irvintim/barn-blinds-controller/enclosure/rev3/check-report.txt

== 1. features
  Bottom valid=True solids=1  70.5 x 79.4 x 8.8 mm
  Lid    valid=True solids=1  70.5 x 79.4 x 16.8 mm
  markings whole and on flat faces: yes
  markings printable (strokes >= 0.6, gaps >= 0.5): yes
  inlays: brand 129 mm3 (26 pieces), labels 412 mm3 (55 pieces)
  vent slots open: 19 of 19
  side tag seated flush in its pocket: yes
  keyholes closed from inside: yes, head channel 1.80 mm tall
== 2. fit against the Rev 1.3 board
  29 of 109 parts can reach the case; testing those
  interference: none
  closest approach (mm):
      0.09  PCB                                      x[-32.5,32.5] y[-37.0,37.0] z[0.00,1.51]  <-- tight
      0.11  BarrelJack_Horizontal001                 x[21.9,36.1] y[-28.7,-19.4] z[-2.31,12.29]  <-- tight
      0.23  USB_Micro-B_XKB_U254-051T-4BH83-F1S      x[-33.0,-28.0] y[-28.7,-21.3] z[0.79,3.90]
      0.29  1786918                                  x[23.7,35.3] y[-11.2,24.6] z[-0.40,12.40]
      0.31  C_0805_2012Metric007                     x[0.4,2.4] y[32.3,33.6] z[-1.33,-0.08]
      0.32  C_0805_2012Metric015                     x[0.4,2.4] y[30.3,31.6] z[-1.33,-0.08]
      0.36  1790182                                  x[28.4,51.8] y[-11.1,24.7] z[0.36,13.65]
      0.41  C_0805_2012Metric005                     x[7.5,9.5] y[2.1,3.4] z[-1.33,-0.08]
      0.41  C_0805_2012Metric011                     x[7.5,9.5] y[23.3,24.6] z[-1.33,-0.08]
      0.65  B1205S-3WR2L-BodyPad001                  x[-12.3,7.4] y[-29.2,-22.2] z[-2.50,11.60]
      0.76  CP_Elec_10x10.5                          x[6.6,20.1] y[24.5,38.1] z[1.59,12.10]
      0.84  D_SMA003                                 x[28.9,31.6] y[15.2,20.2] z[-2.31,-0.08]
      0.84  D_SMA005                                 x[28.9,31.6] y[0.8,5.8] z[-2.31,-0.08]
      0.84  D_SMA007                                 x[28.9,31.6] y[22.3,27.3] z[-2.31,-0.08]
      0.84  D_SMA009                                 x[28.9,31.6] y[8.0,13.0] z[-2.31,-0.08]
      0.84  D_SMA011                                 x[-25.5,-20.5] y[-12.8,-10.1] z[-2.31,-0.08]
      0.84  D_SMA013                                 x[-25.5,-20.5] y[-17.4,-14.7] z[-2.31,-0.08]
      1.02  C_0805_2012Metric017                     x[-0.5,1.5] y[22.0,23.2] z[-1.33,-0.08]
      1.02  C_0805_2012Metric019                     x[-0.5,1.5] y[24.0,25.3] z[-1.33,-0.08]
      1.06  SOT-238                                  x[-22.8,-19.8] y[25.3,27.8] z[-1.28,-0.09]
      1.61  C_0805_2012Metric013                     x[-18.8,-16.8] y[28.1,29.4] z[-1.33,-0.08]
      1.81  C_0805_2012Metric009                     x[3.0,5.0] y[-22.0,-20.7] z[-1.33,-0.08]
      1.86  SOT-236                                  x[-26.3,-23.8] y[0.5,3.5] z[-1.28,-0.09]
      1.86  SOT-240                                  x[-26.2,-23.7] y[-4.5,-1.5] z[-1.28,-0.09]
      1.96  SOT-234                                  x[-28.0,-25.1] y[-26.2,-23.9] z[-1.19,-0.09]
      2.00  D_0805_2012Metric001                     x[-30.6,-29.4] y[26.4,28.4] z[1.59,2.40]
== 3. parameter robustness
  {'board_l': 80.0}                             ok
  {'wall': 3.0, 'edge_r': 1.5}                  ok
  {'kh_dx': 12.0, 'tv_n': 7, 'sv_n': 5}         ok
  {'headroom': 16.0, 'r_out': 4.0}              ok
  {'din_spacing': 36.0, 'side_cy': 3.0}         ok
== 4. exports
   exports/project-case-rev3-bottom.stl closed
   exports/project-case-rev3-lid.stl closed
   exports/project-case-rev3-lid-inlay-brand.stl closed
   exports/project-case-rev3-lid-inlay-labels.stl closed
   exports/project-case-rev3-side-tag.stl closed
   renders/assembled-plusX.png
   renders/assembled-minusX.png
   renders/tray-with-board.png
   renders/tray-inside.png
   renders/side-mount-minusX.png
   renders/tray-underside.png
   renders/lid-underside.png
   renders/lid-top-markings.png
   renders/tray-underside-markings.png
   renders/side-tag-plusX.png
== result: PASS
