irvintim/barn-blinds-controller/enclosure/rev3/renders/lid-underside.png

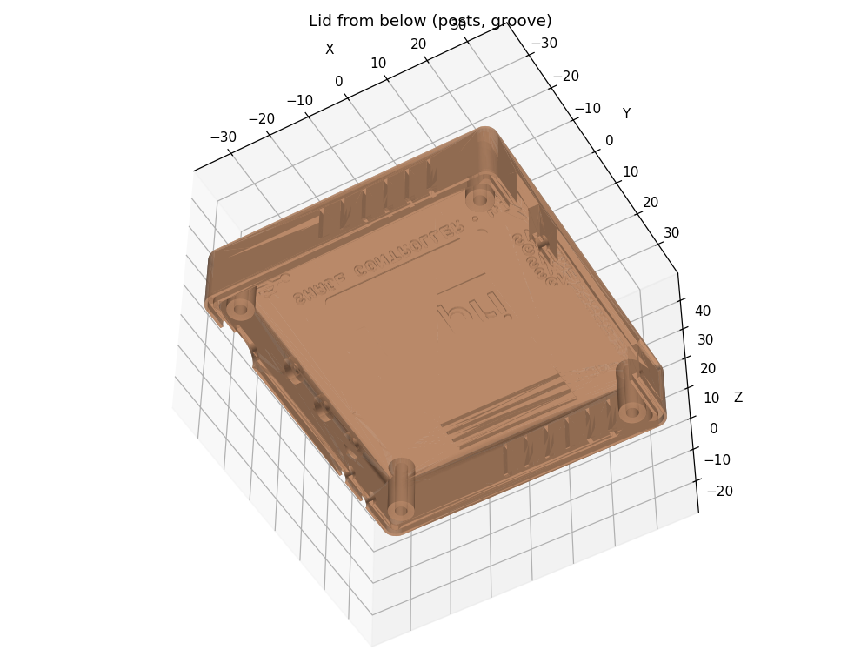
enclosure/rev3/renders/lid-underside.png
