irvintim/barn-blinds-controller/enclosure/rev3/renders/side-mount-minusX.png

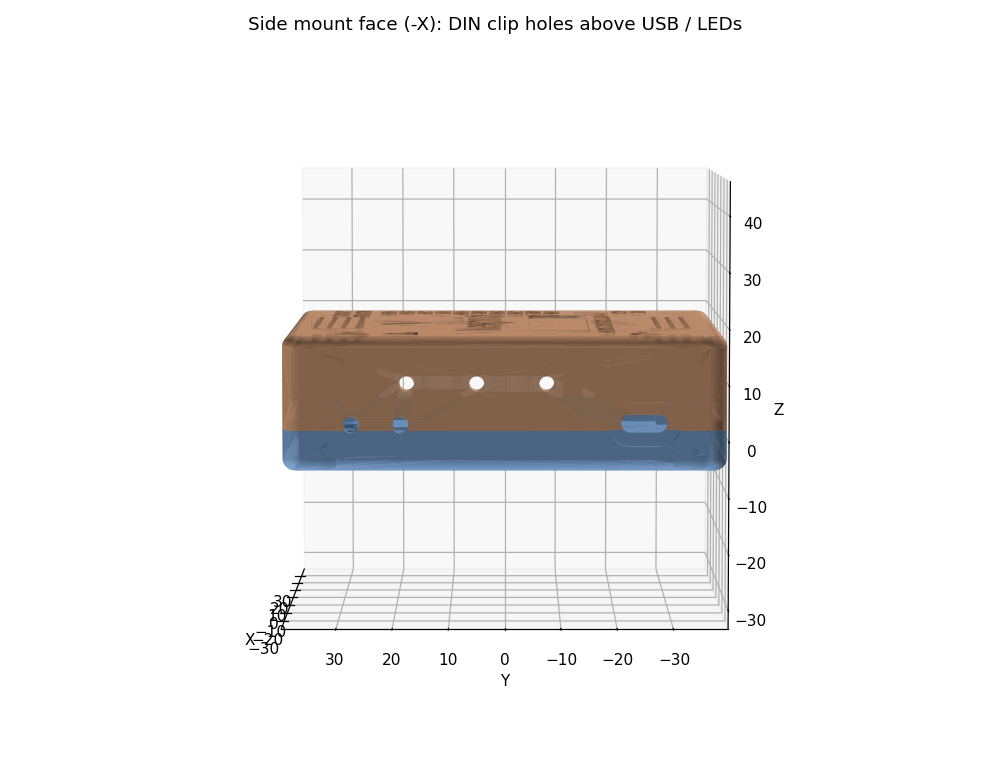
enclosure/rev3/renders/side-mount-minusX.png
