irvintim/barn-blinds-controller/enclosure/rev3/renders/tray-inside.png

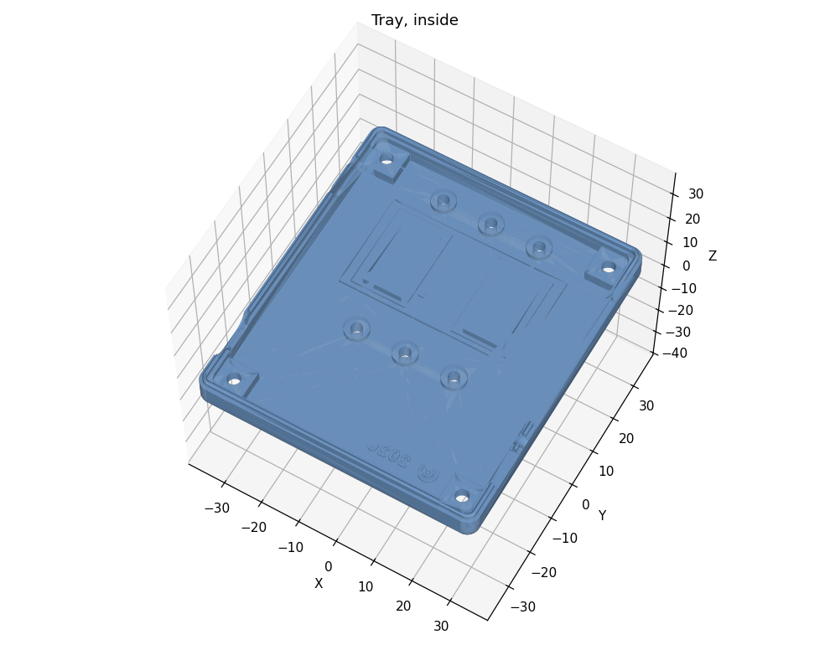
enclosure/rev3/renders/tray-inside.png
