irvintim/barn-blinds-controller/enclosure/rev3/renders/tray-underside-markings.png

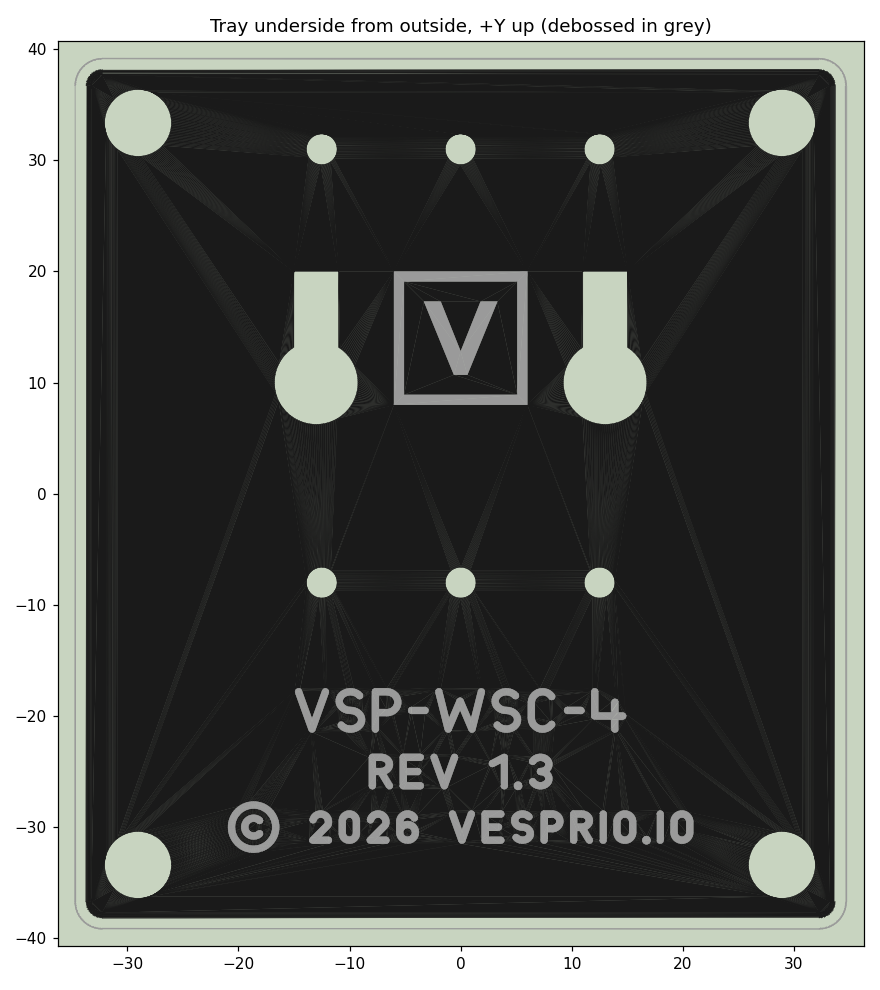
enclosure/rev3/renders/tray-underside-markings.png
