irvintim/barn-blinds-controller/enclosure/rev3/renders/tray-underside.png

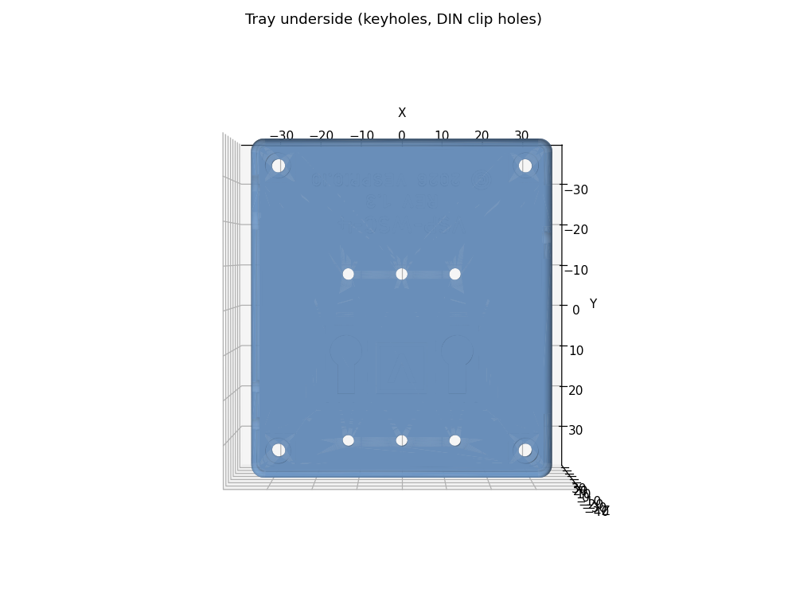
enclosure/rev3/renders/tray-underside.png
