irvintim/barn-blinds-controller/enclosure/rev3/renders/tray-with-board.png

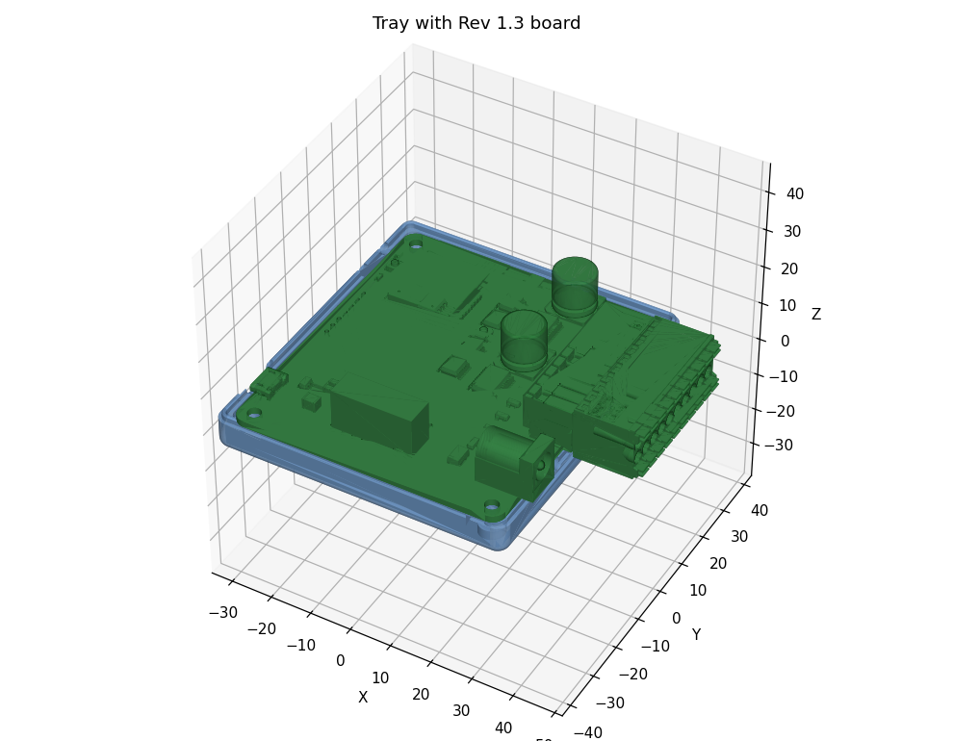
enclosure/rev3/renders/tray-with-board.png
