irvintim/barn-blinds-controller/LIB_SLC03A-05/SLC03A-05/3D/Pasted image.png

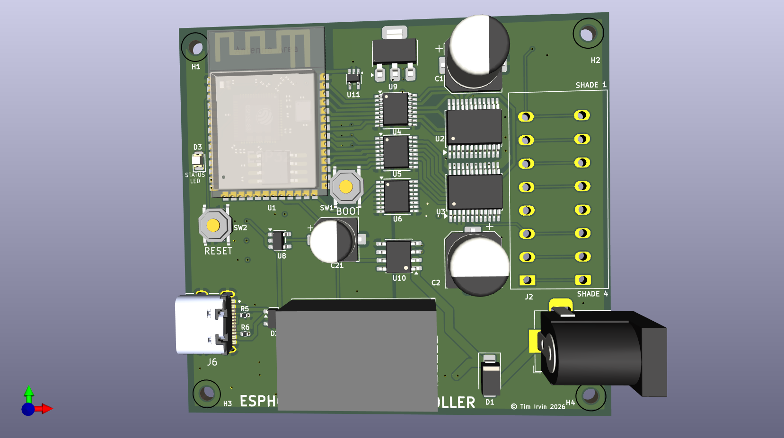
LIB_SLC03A-05/SLC03A-05/3D/Pasted image.png
