irvintim/barn-blinds-controller/pcb/main-board/fab/vsp-wsc4-rev1.3/cdadb2f582784c6c8320a630f22a9e84_T.png

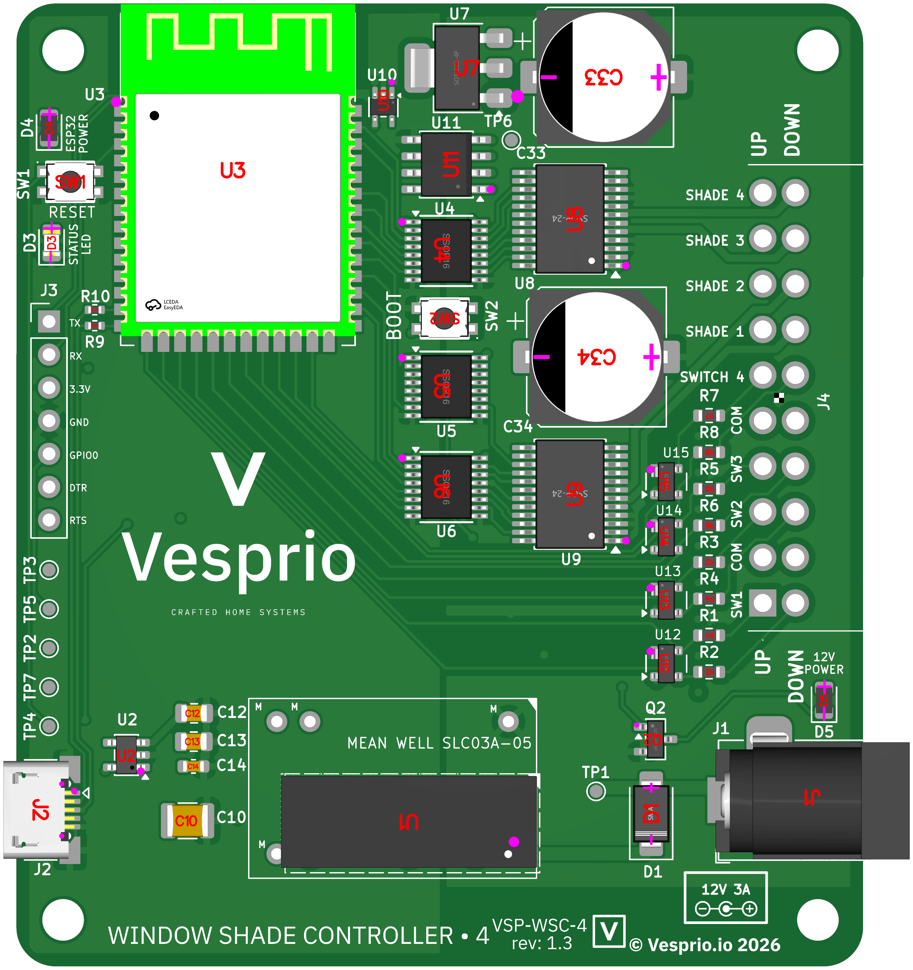
pcb/main-board/fab/vsp-wsc4-rev1.3/cdadb2f582784c6c8320a630f22a9e84_T.png
