irvintim/barn-blinds-controller/production/537245f37e364ca3bb9c5b8609c065dc_B.png

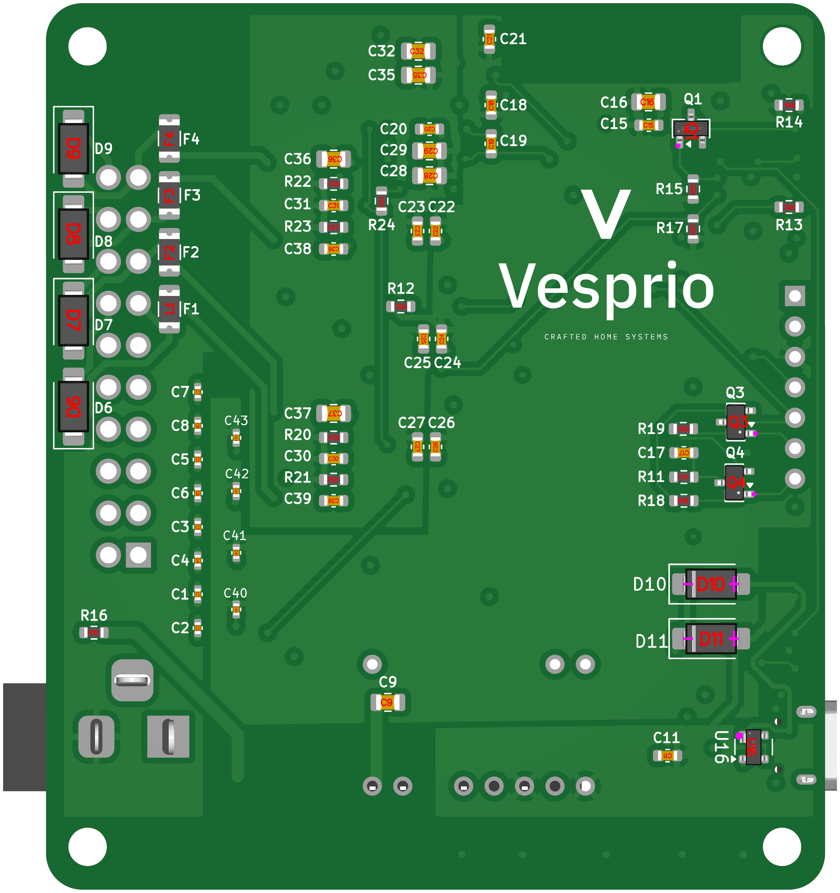
production/537245f37e364ca3bb9c5b8609c065dc_B.png
