irvintim/barn-blinds-controller/barn-blinds-controller-JLCPCB-BOM-v1.1.xlsx

Comment | Designator | Footprint | JLCPCB Part#(optional)
22uF 25V | C1 | 0805 | C45783
100uF | C2 | CP_Elec_6.3x5.4 | C7469977
0.1uF 25V | C3,C6,C7,C_ACS1,C_ISO_A1,C_ISO_B1,C_ISO_C1,C_ISO_D1,C_ISO_E1,C_ISO_F1,C_TMP1 | 0603 | C1590
10uF 10V | C4,C8,C_VCC_A1,C_VCC_A2 | 0805 | C17024
22uF 10V | C5,C10 | 0805 | C29277
10uF 25V | C9,C_VM_A1,C_VM_A2 | 0805 | C15850
1000uF 25V | C11,C12 | CP_Elec_10x10.5 | C7471896
10nF 10V | C_ACS2 | 0603 | C519405
1nF 10V | C_FILT1 | 0603 | C519402
0.1uF 25V | C_VCC_B1,C_VCC_B2,C_VM_B1,C_VM_B2 | 0603 | C1590
SS34 | D1 | SMA | C8678
BAT54S | D2 | SOT-23 | C8592
SMBJ15CA | D4,D5,D6,D7 | SMB | C19077570
Polyfuse mSMD110 | F1,F2,F3,F4 | 1812 | C69691
DC005-T25 | J1 | BarrelJack_Horizontal | C111573
KH-TYPE-C-16P | J2 | KH-TYPE-C-16P | C709357
Conn_01x08 3.5mm | J3 | TerminalBlock_JL271R_1x08_P3.50mm | C5137858
5.1K | R1,R4 | 0402 | C25905
22R | R2,R3 | 0402 | C25092
10K | R5,R6,R7,R8,R9,R10,R_BOOT1 | 0603 | C25804
330R | R_LED1 | 0603 | C23138
BOOT | SW1 | SW-SMD_4P | C51927445
BOOT | SW2 | SW-SMD_4P | C51927445
AP2112K-3.3 | U2 | SOT-23-5 | C23380830
ESP32-S3-WROOM-1 | U3 | ESP32-S3-WROOM-1 | C2913197
ISO7760DBQ | U4,U5,U6 | SSOP-16 | C2868628
AMS1117-3.3 | U7 | SOT-223 | C6186
TB6612FNG | U8,U9 | SSOP-24 | C88224
TMP235 | U10 | SC-70-5 | C2861437
ACS723xLCTR-05AB | U11 | SOIC-8 | C2655492
Red LED | D3 | 0805 | C84256
