irvintim/barn-blinds-controller/JLCPCB_BOM_Template.xls

Comment | Designator | Footprint | JLCPCB Part#(optional)
100uF | C1 | CASE-B_3528 | C16133
100nF | C2, C9, C10 | 0603 | C14663
300KΩ | R4, R7 | 0603 | C23024
15KΩ | R5, R6 | 0603_R | C22809
100KΩ | R1, R3 | 0603_R | C25803
10uF | C3-5 | 1206_C | C13585
100Ω | R2 | 0603_R | C22775
1N4148WS | D1 | SOD-323 | C2128
LM358DR2G | U1 | SOIC-8_150mil | C7950
HT7550-1 | VR1 | SOT-89(SOT-89-3) | C16106
