irvintim/barn-blinds-controller/enclosure/reference/barn-blinds-controller.FCStd

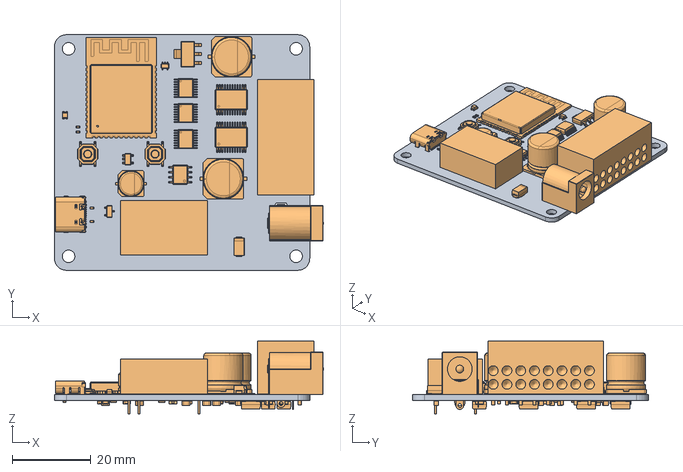
[picture p12: CAD file, 2026-07-08]
enclosure/reference/barn-blinds-controller.FCStd
68.5 x 60.0 x 18.5 mm
PCB_Compound
Component_Compound
