irvintim/barn-blinds-controller/enclosure/rev3/exports/project-case-rev3-lid.stl

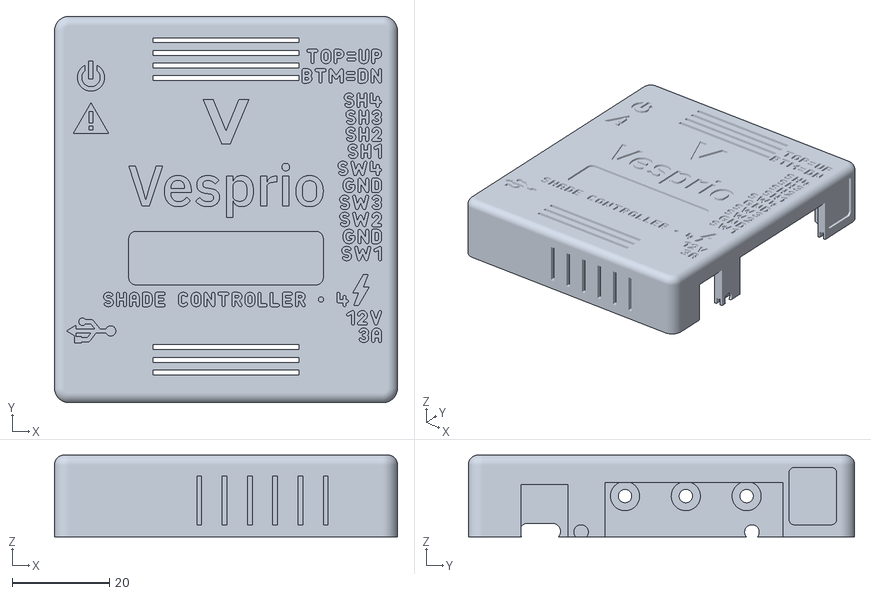
[picture p13: CAD file, 2026-10-15]
enclosure/rev3/exports/project-case-rev3-lid.stl
70.5 x 79.4 x 16.8
