irvintim/barn-blinds-controller/enclosure/rev3/project-case-rev3.FCStd

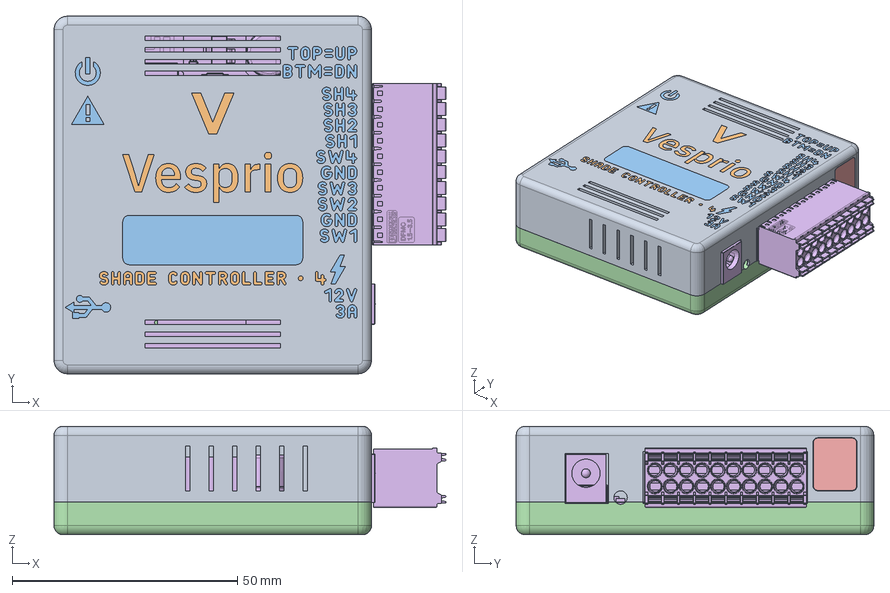
[picture p14: CAD file, 2026-10-15]
enclosure/rev3/project-case-rev3.FCStd
87.0 x 79.4 x 24.1 mm
LidPrint
InlayBrand
InlayLabels
TrayPrint
SideTag (print flat, white; glue into the +X wall pocket)
Board Rev 1.3 (reference, not printed)
