irvintim/barn-blinds-controller/KH-TYPE-C-16P/KH-TYPE-C-16P.step

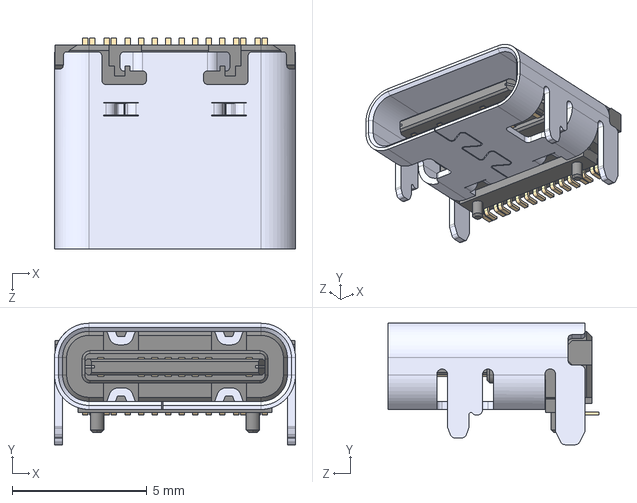
[picture p15: CAD file, 2026-04-21]
KH-TYPE-C-16P/KH-TYPE-C-16P.step
8.94 x 4.51 x 7.81 mm
