irvintim/barn-blinds-controller/LIB_SLC03A-05/SLC03A-05/3D/SLC03A-05.stp

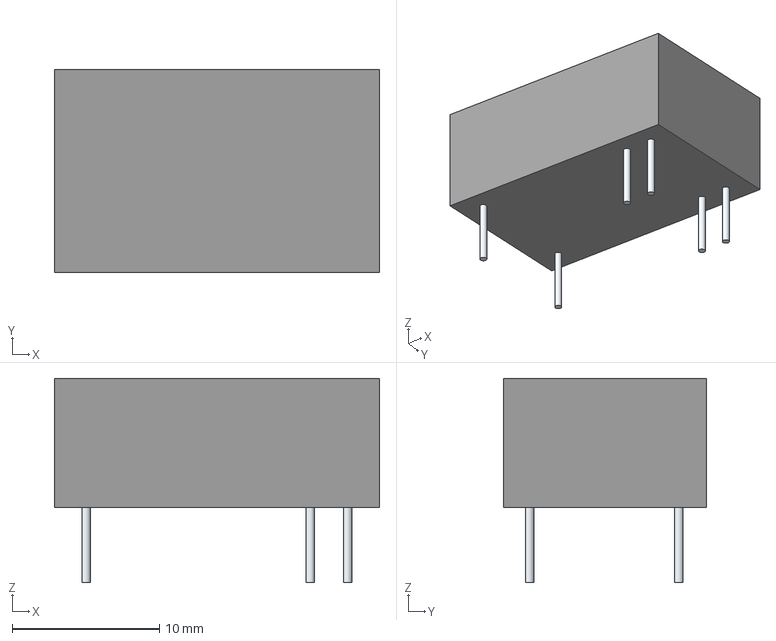
[picture p16: CAD file, 2026-04-21]
LIB_SLC03A-05/SLC03A-05/3D/SLC03A-05.stp
22.1 x 13.8 x 13.9 mm
Leads x 6
