irvintim/barn-blinds-controller/project-case-BodyPocket004.stl

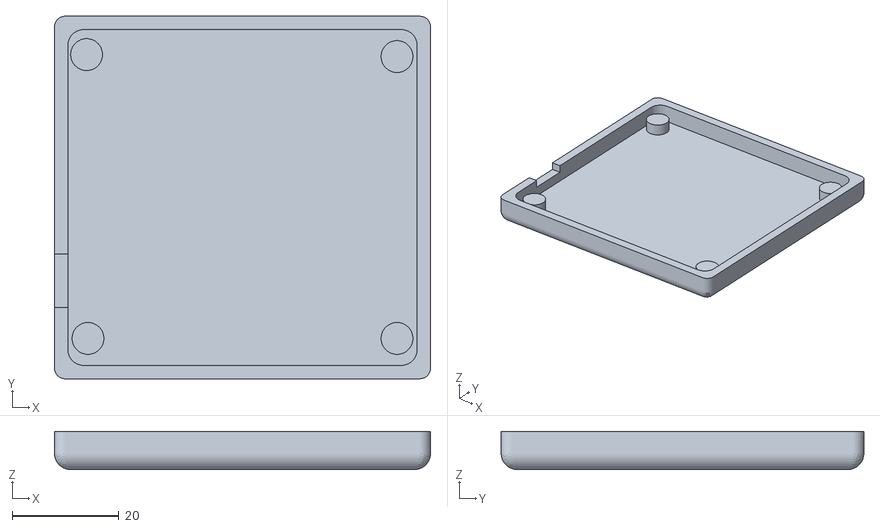
[picture p17: CAD file, 2026-07-08]
project-case-BodyPocket004.stl
70.5 x 68.0 x 7.16
