irvintim/barn-blinds-controller/enclosure/reference/1597DIN2GY.stp

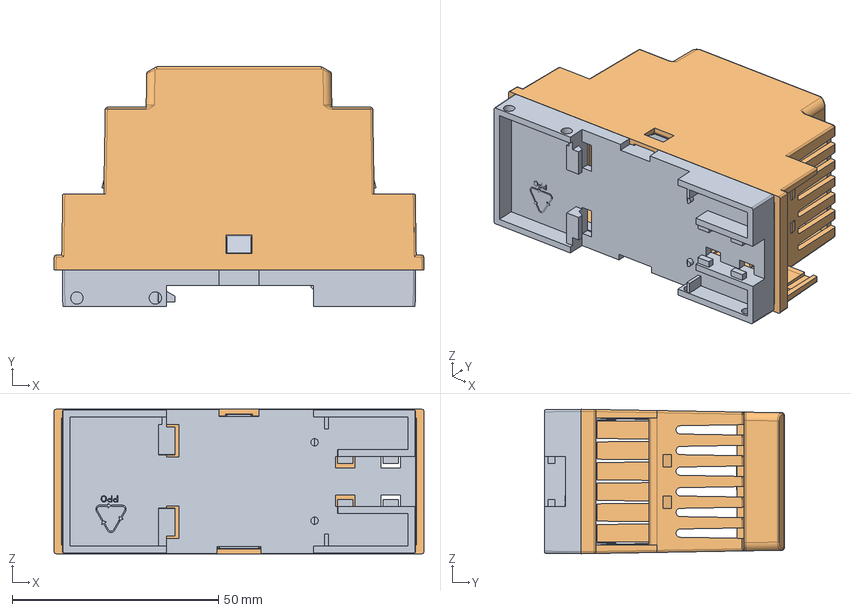
[picture p18: CAD file, 2026-06-30]
enclosure/reference/1597DIN2GY.stp
89.6 x 58.0 x 35.0 mm
350_base_121113
top_stbx_35mm_rev-a
