irvintim/barn-blinds-controller/enclosure/rev3/exports/project-case-rev3-bottom.stl

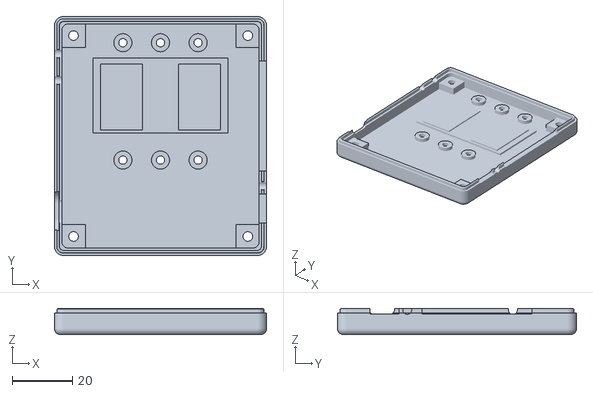
[picture p19: CAD file, 2026-10-15]
enclosure/rev3/exports/project-case-rev3-bottom.stl
70.5 x 79.4 x 8.75
