irvintim/barn-blinds-controller/enclosure/rev3/exports/project-case-rev3-lid-inlay-labels.stl

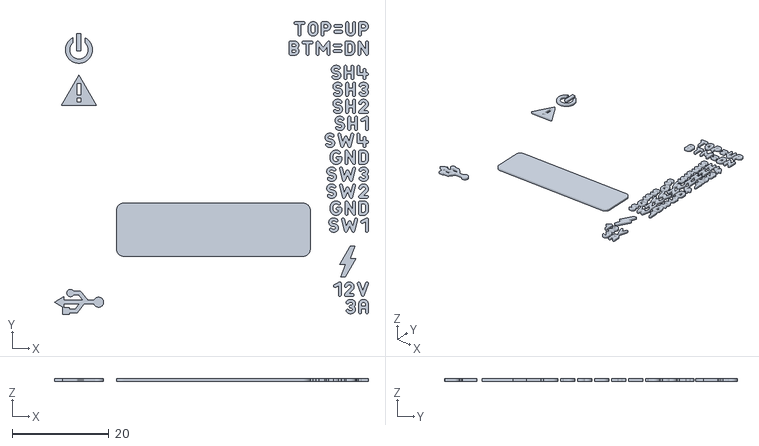
[picture p20: CAD file, 2026-10-15]
enclosure/rev3/exports/project-case-rev3-lid-inlay-labels.stl
64.8 x 60.4 x 0.6
