irvintim/barn-blinds-controller/project-case-Cut001.stl

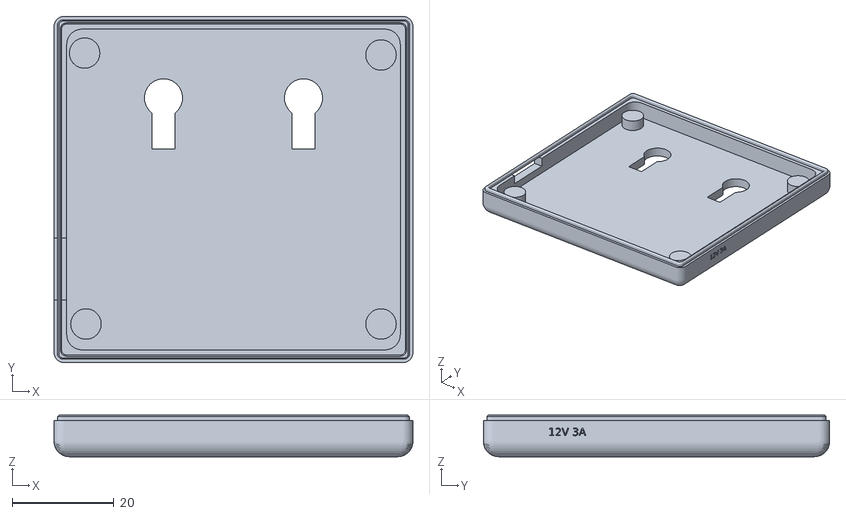
[picture p21: CAD file, 2026-07-08]
project-case-Cut001.stl
70.5 x 68.0 x 8.16
