irvintim/barn-blinds-controller/project-case-TopPocket011.stl

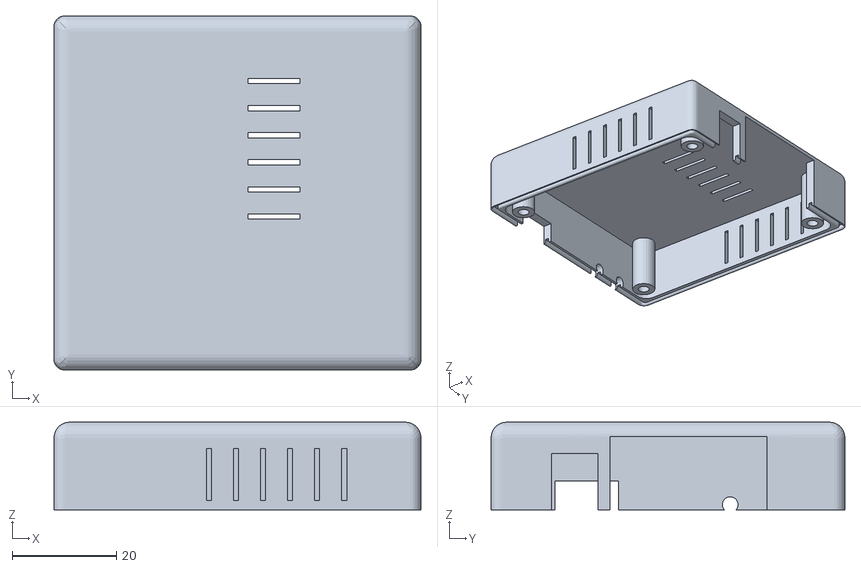
[picture p22: CAD file, 2026-07-08]
project-case-TopPocket011.stl
70.5 x 68.0 x 16.8
