irvintim/barn-blinds-controller/enclosure/rev3/exports/project-case-rev3-lid-inlay-brand.stl

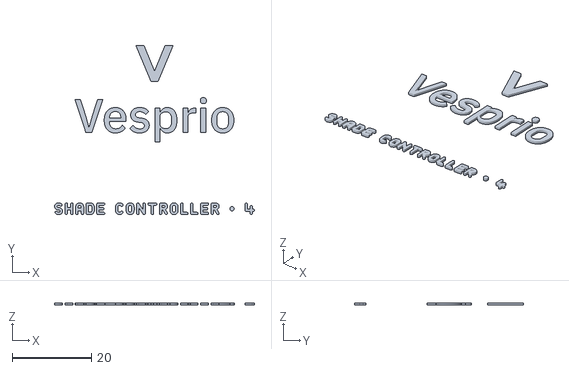
[picture p23: CAD file, 2026-10-15]
enclosure/rev3/exports/project-case-rev3-lid-inlay-brand.stl
50.4 x 42.7 x 0.6
