irvintim/barn-blinds-controller/project-case.FCStd

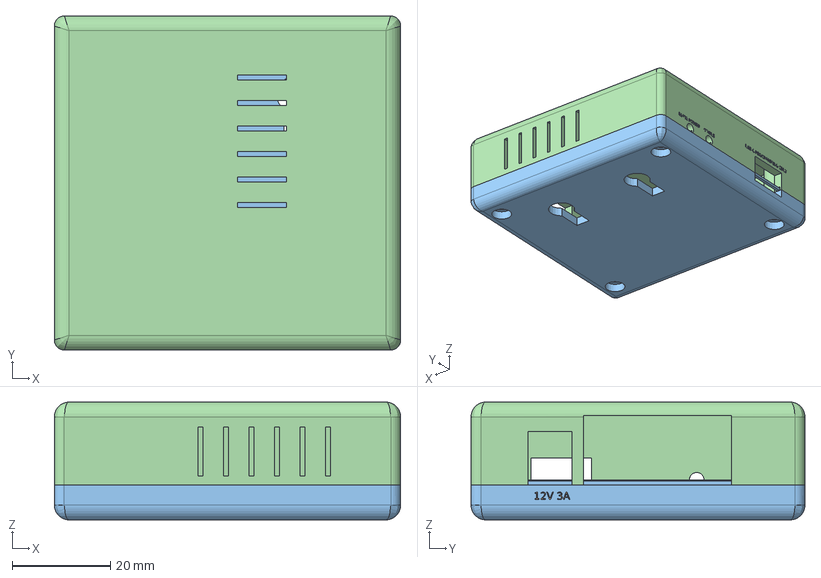
[picture p24: CAD file, 2026-07-08]
project-case.FCStd
70.5 x 68.0 x 24.0 mm
ShapeString006
