irvintim/barn-blinds-controller/enclosure/rev3/exports/lid-proof-base.stl

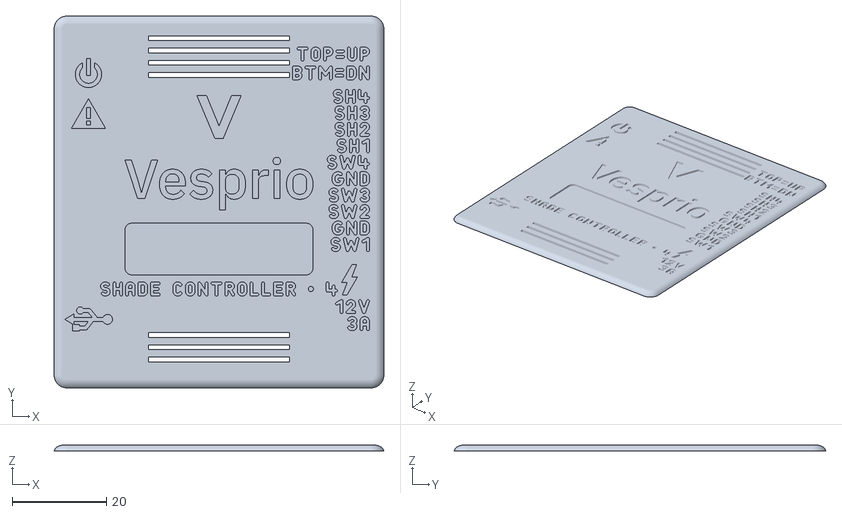
[picture p25: CAD file, 2026-10-15]
enclosure/rev3/exports/lid-proof-base.stl
70.2 x 79.1 x 1.20
