irvintim/barn-blinds-controller/R15P23.3S_X2_P_R6.4--3DModel-STEP-510211.STEP

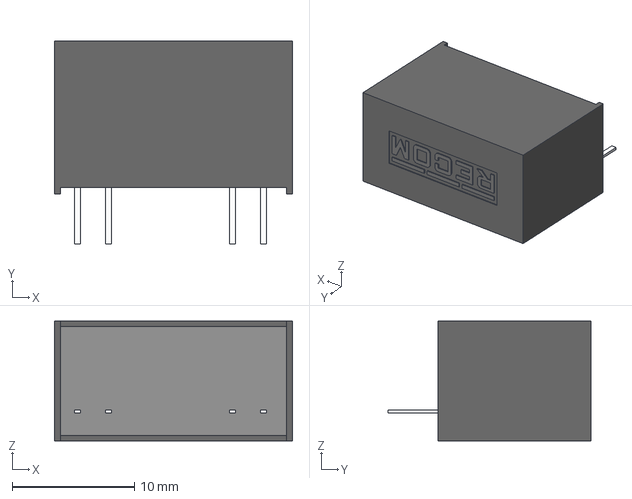
[picture p26: CAD file, 2026-07-08]
R15P23.3S_X2_P_R6.4--3DModel-STEP-510211.STEP
19.5 x 16.6 x 9.80 mm
