irvintim/barn-blinds-controller/enclosure/rev3/exports/project-case-rev3-side-tag.stl

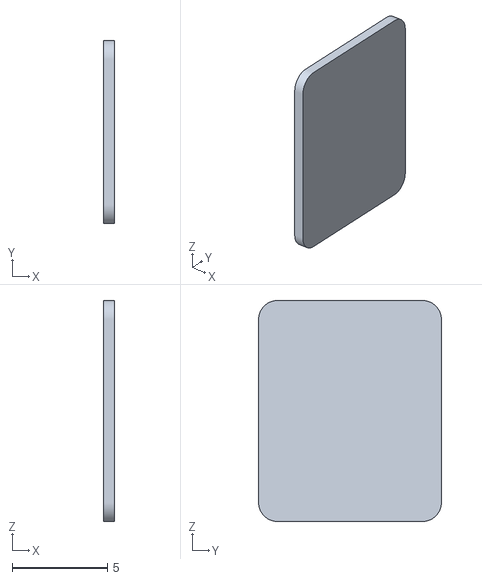
[picture p27: CAD file, 2026-10-15]
enclosure/rev3/exports/project-case-rev3-side-tag.stl
0.6 x 9.60 x 11.6
