irvintim/barn-blinds-controller/project-case-repaired.FCStd

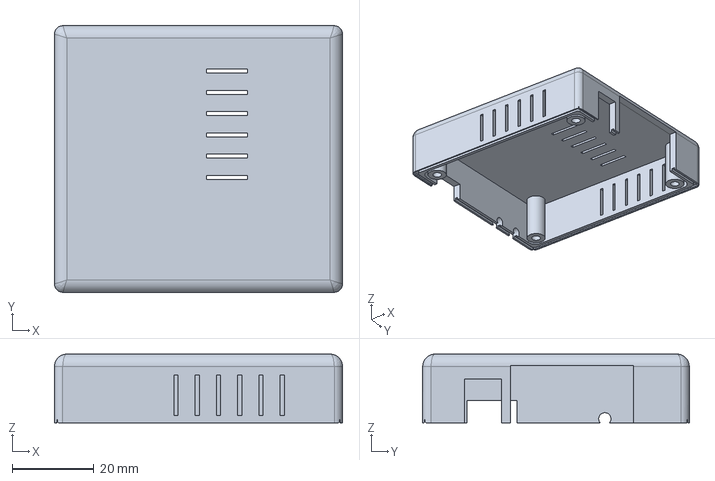
[picture p28: CAD file, 2026-07-08]
project-case-repaired.FCStd
70.5 x 65.2 x 16.8 mm
