irvintim/barn-blinds-controller/enclosure/rev3/exports/inlay-test-tile-base.stl

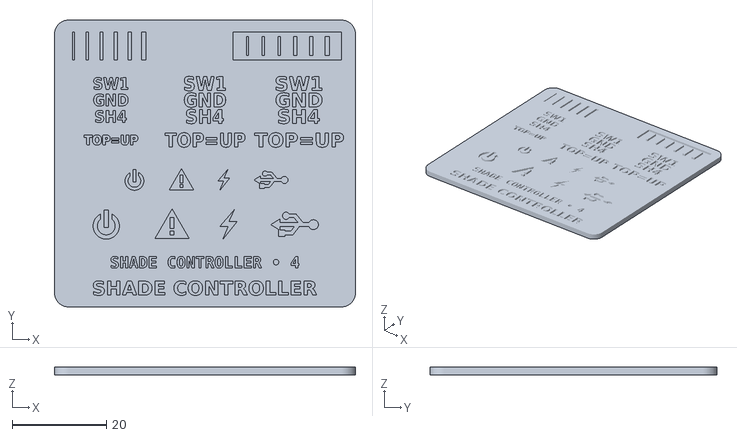
[picture p29: CAD file, 2026-10-15]
enclosure/rev3/exports/inlay-test-tile-base.stl
64.0 x 61.0 x 1.60
