irvintim/barn-blinds-controller/project-case-Body001LinearPattern.step

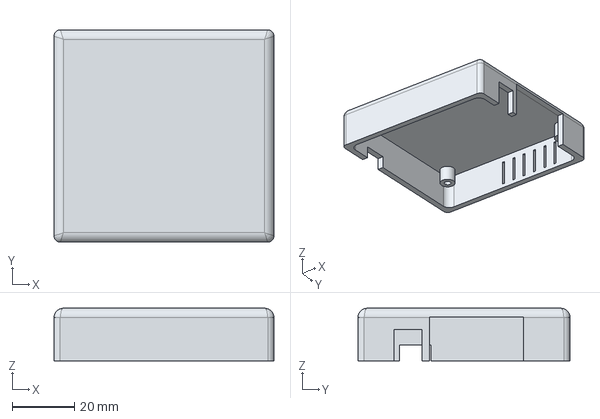
[picture p30: CAD file, 2026-07-08]
project-case-Body001LinearPattern.step
70.5 x 68.0 x 16.8 mm
