irvintim/barn-blinds-controller/enclosure/rev3/exports/inlay-test-tile-white.stl

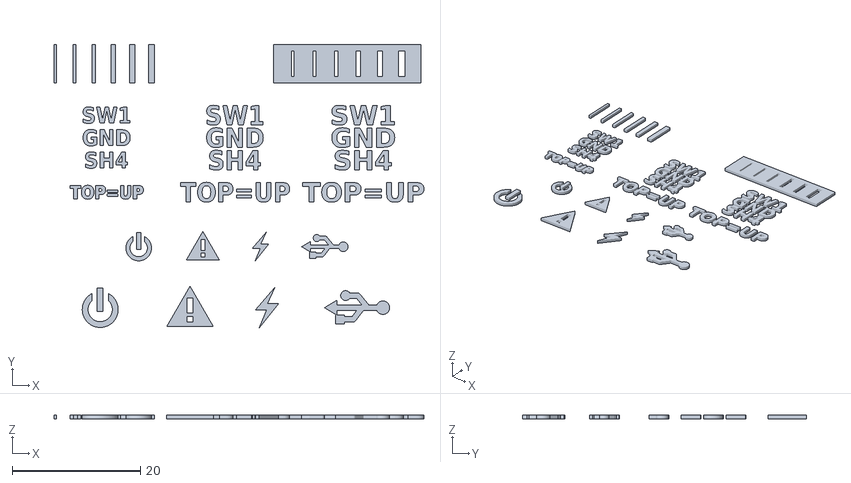
[picture p31: CAD file, 2026-10-15]
enclosure/rev3/exports/inlay-test-tile-white.stl
57.7 x 44.2 x 0.6
