irvintim/barn-blinds-controller/enclosure/rev3/exports/inlay-test-tile-blue.stl

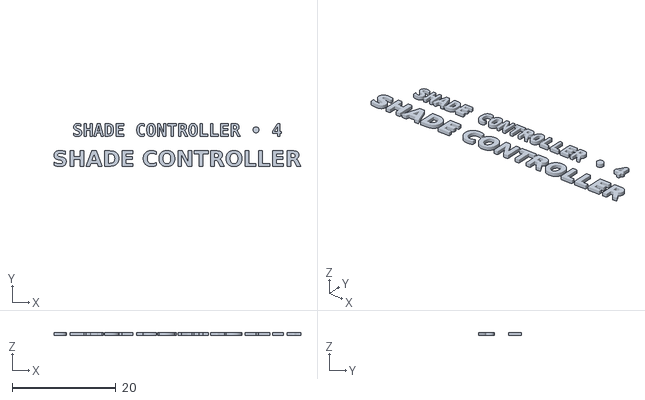
[picture p32: CAD file, 2026-10-15]
enclosure/rev3/exports/inlay-test-tile-blue.stl
47.5 x 8.32 x 0.6
