irvintim/barn-blinds-controller/JL271R-35008G01.FCStd

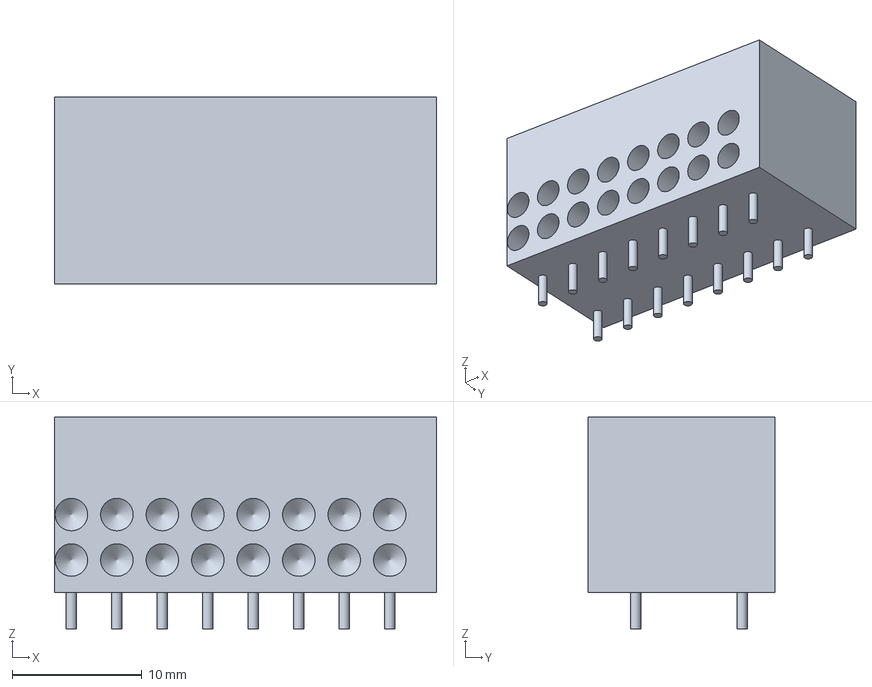
[picture p33: CAD file, 2026-04-24]
JL271R-35008G01.FCStd
29.4 x 14.4 x 16.3 mm
