irvintim/barn-blinds-controller/EEVTG2A221M.STEP

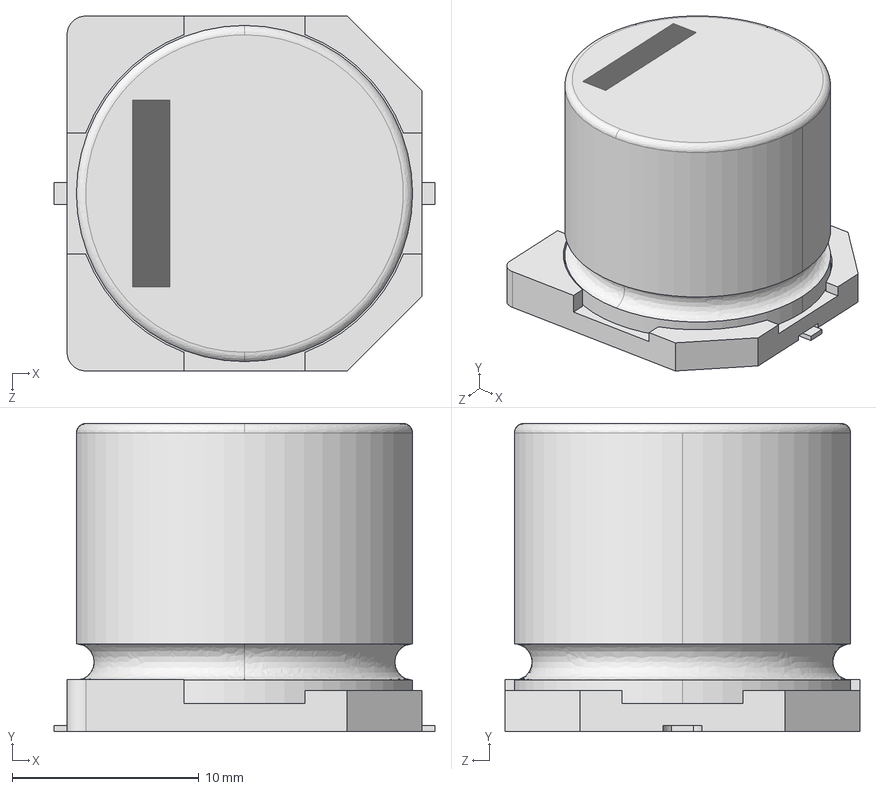
[picture p34: CAD file, 2026-04-23]
EEVTG2A221M.STEP
20.4 x 16.5 x 19.0 mm
