irvintim/barn-blinds-controller/(list of files, cad)

Other CAD files:
project-case-rev2-TopSketch020.stl
enclosure/rev3/exports/lid-proof-white.stl
enclosure/rev3/exports/lid-proof-blue.stl
project-case-BottomChamfer.stl
B1205S-3WR2L-BodySketch001.step
barn-blinds-controller.step
JL271R-35008G01-BodyPad001.stl
JL217R-35008G01-BodyPad001.step
1054070/3D/1054070.stp
1054070/Allegro/1054070.psm
1054070/DEHDL/1054070/chips/chips.prt
1786918/Allegro/1786918.psm
1786918/DEHDL/1786918/chips/chips.prt
1787470/3D/1787470.stp
1787470/Allegro/1787470.psm
1787470/DEHDL/1787470/chips/chips.prt
1790373/1790373.stp
JL217R-35008G01-BodyPad001.stl
LIB_SLC03A-05/SLC03A-05/Allegro/slc03a05.psm
LIB_SLC03A-05/SLC03A-05/DEHDL/slc03a_05/chips/chips.prt
enclosure/archive/rev1/exports/project-case-Body001LinearPattern.stl
enclosure/archive/rev1/exports/project-case-BottomChamfer.stl
enclosure/archive/rev1/exports/project-case.amf
enclosure/rev2/exports/Assembly.3mf
enclosure/rev2/exports/project-case-rev2-BottomPocket013.stl
enclosure/rev2/exports/project-case-rev2-BottomPocket018.stl
enclosure/rev2/exports/project-case-rev2-TopPocket015.stl
enclosure/rev2/project-case-rev2.FCStd
project-case-Body001LinearPattern.stl
project-case-Cut001.amf
project-case.3mf
project-case.amf
