irvintim/barn-blinds-controller/enclosure/rev3/renders/assembled-minusX.png

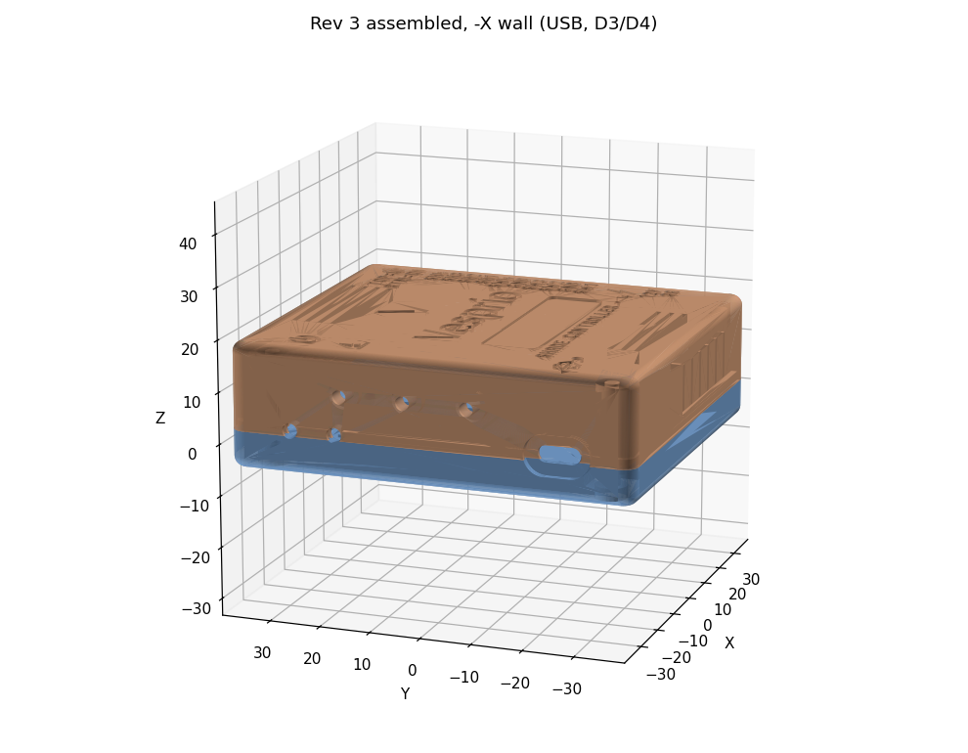
enclosure/rev3/renders/assembled-minusX.png
