irvintim/barn-blinds-controller/docs/project-context/vsp-wsc4-rev13-bringup-status.md

# VSP-WSC-4 Rev 1.3 — Bring-up STATUS LOG

**Live status of the physical Rev 1.3 boards.** Updated 2026-10-11.

This is the "where did I leave off" file. The step-by-step test plan is
`vsp-wsc4-rev13-bringup-procedure.md`; the config is
`vsp-wsc4-rev13-bringup.yaml`. Everything needed is git-tracked — nothing
important lives only on one machine.

---

## THE NEXT THING TO DO

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

What is left needs the **real shade motors** (they are on the job site):
1. Measure each shade motor's **inrush and stall current** — with a clamp meter
   or a bench supply, NOT through a board first. This sets the stall threshold
   and confirms the motors are inside the TB6612FNG's 1.2 A / 3.2 A rating.
2. Then run one real shade motor on board 2 under control, watching Reset Reason
   for brownout (Rev 1.4 item 4: the ESP32 drops out below ~8.5 V on `+12V_RAW`).
3. Confirm which physical direction "OPEN" drives.

**Still the rule: no motor on any board until step 1 is done.** A non-shade
motor destroyed board 1's U8. Resistive load for anything else: **20-33 ohm,
10 W cement** (never below 20 ohm on an output).

Firmware items found today (not board items): switch debounce in all configs,
soft-start, Tasmota switch inputs + stall detection. See the Product Track list
in `vsp-wsc4-todo.md`.

---

## Board inventory

| Board | State | Notes |
|---|---|---|
| **1** | **FAULTY — U8 destroyed** | VM and 3 of 4 output legs shorted to PGND. Repairable: replace U8 (SSOP-24), confirm VM->PGND open before applying 12 V. Nothing else on it is damaged. |
| **2** | Healthy — **now running Tasmota 15.6.0.3** | Full resistance baseline taken 2026-09-03 — every reading open. **Use board 2 as the reference when a board is suspect.** Reflashed from ESPHome to Tasmota 2026-10-11 (serial, via J3); to go back to the bring-up config it needs a serial/USB flash again. |
| 3-5 | Unopened | |

---

## Status at a glance

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

---

## Findings this session (all fixed in the repo, all worth remembering)

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

```
GPIO42 -> U3.35 -> ISO_SH3_OPEN -> U4.4 (INC) -> U4.13 (OUTC)
       -> SH3_IN1 -> U8.17 (BIN1) -> ch B -> BO1/BO2 -> SHADE4 -> J4.10/20
```

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

---

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

Note TP1 is `Net-(D1-A)` (the raw input, *before* D1), not `+12V`.

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

### 14. Tasmota on Rev 1.3 — all four shutters work, and why Rev 1.2's didn't (2026-10-11)
**Passed:** Shade 1 ±11.31 V, 2 ±11.47 V, 3 ±11.10 V, 4 ±11.36 V, each driving
only its own J4 pair, opposite polarity open/close, `ShutterStop` works, no
restarts. Tasmota 15.6.0.3. Full procedure and template:
`tasmota-setup-commands.txt`. Things that cost time, in order:

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

---

## Working on a different machine

**Normal path (what is actually used):** `git pull`, open
`vsp-wsc4-rev13-bringup.yaml` in the IDE, copy the whole file, paste it into the
ESPHome Docker dashboard's web editor, Save + Install. See Finding 9 for the
traps that come with this.

**CLI path**, if ever needed:

```bash
git pull
python3 -m venv ~/.venvs/esphome && ~/.venvs/esphome/bin/pip install esphome
cp docs/project-context/secrets.yaml.example docs/project-context/secrets.yaml  # then edit
~/.venvs/esphome/bin/esphome run docs/project-context/vsp-wsc4-rev13-bringup.yaml
```

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

---

## Deferred by decision

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

## For Rev 1.4

**The canonical Rev 1.4 list lives in `vsp-wsc4-todo.md` under
"Rev 1.4 PCB Changes".** Add new items there, not here, so the two do not
drift. As of 2026-10-11 none of them is required for the shade-controller use
case — see "THE NEXT THING TO DO" above.
