irvintim/barn-blinds-controller/enclosure/rev3/renders/inlay-test-tile.png

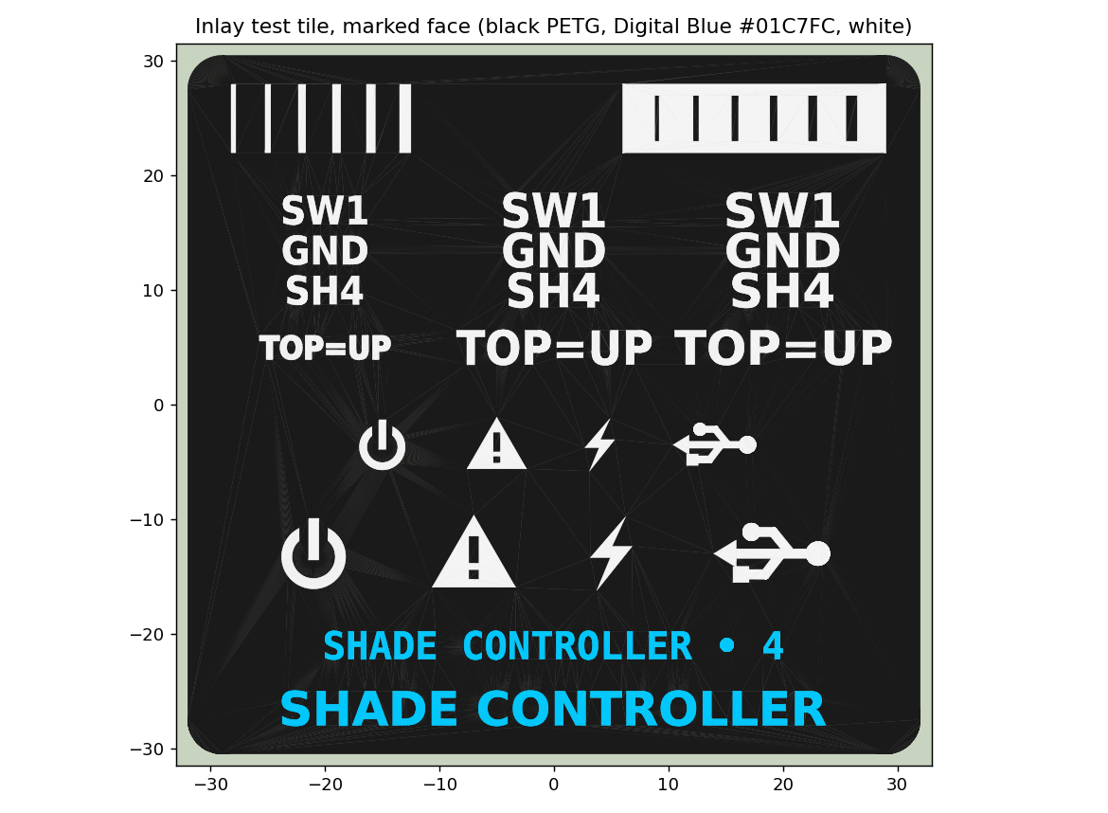
enclosure/rev3/renders/inlay-test-tile.png
