irvintim/barn-blinds-controller/(list of files, drawings)

Other design files:
1786918/Altium/1786918.PcbLib
1786918/Altium/1786918.SchLib
