irvintim/barn-blinds-controller/pcb/main-board/barn-blinds-controller.kicad_pcb

## KiCad design pcb/main-board/barn-blinds-controller.kicad_pcb (2026-10-12)

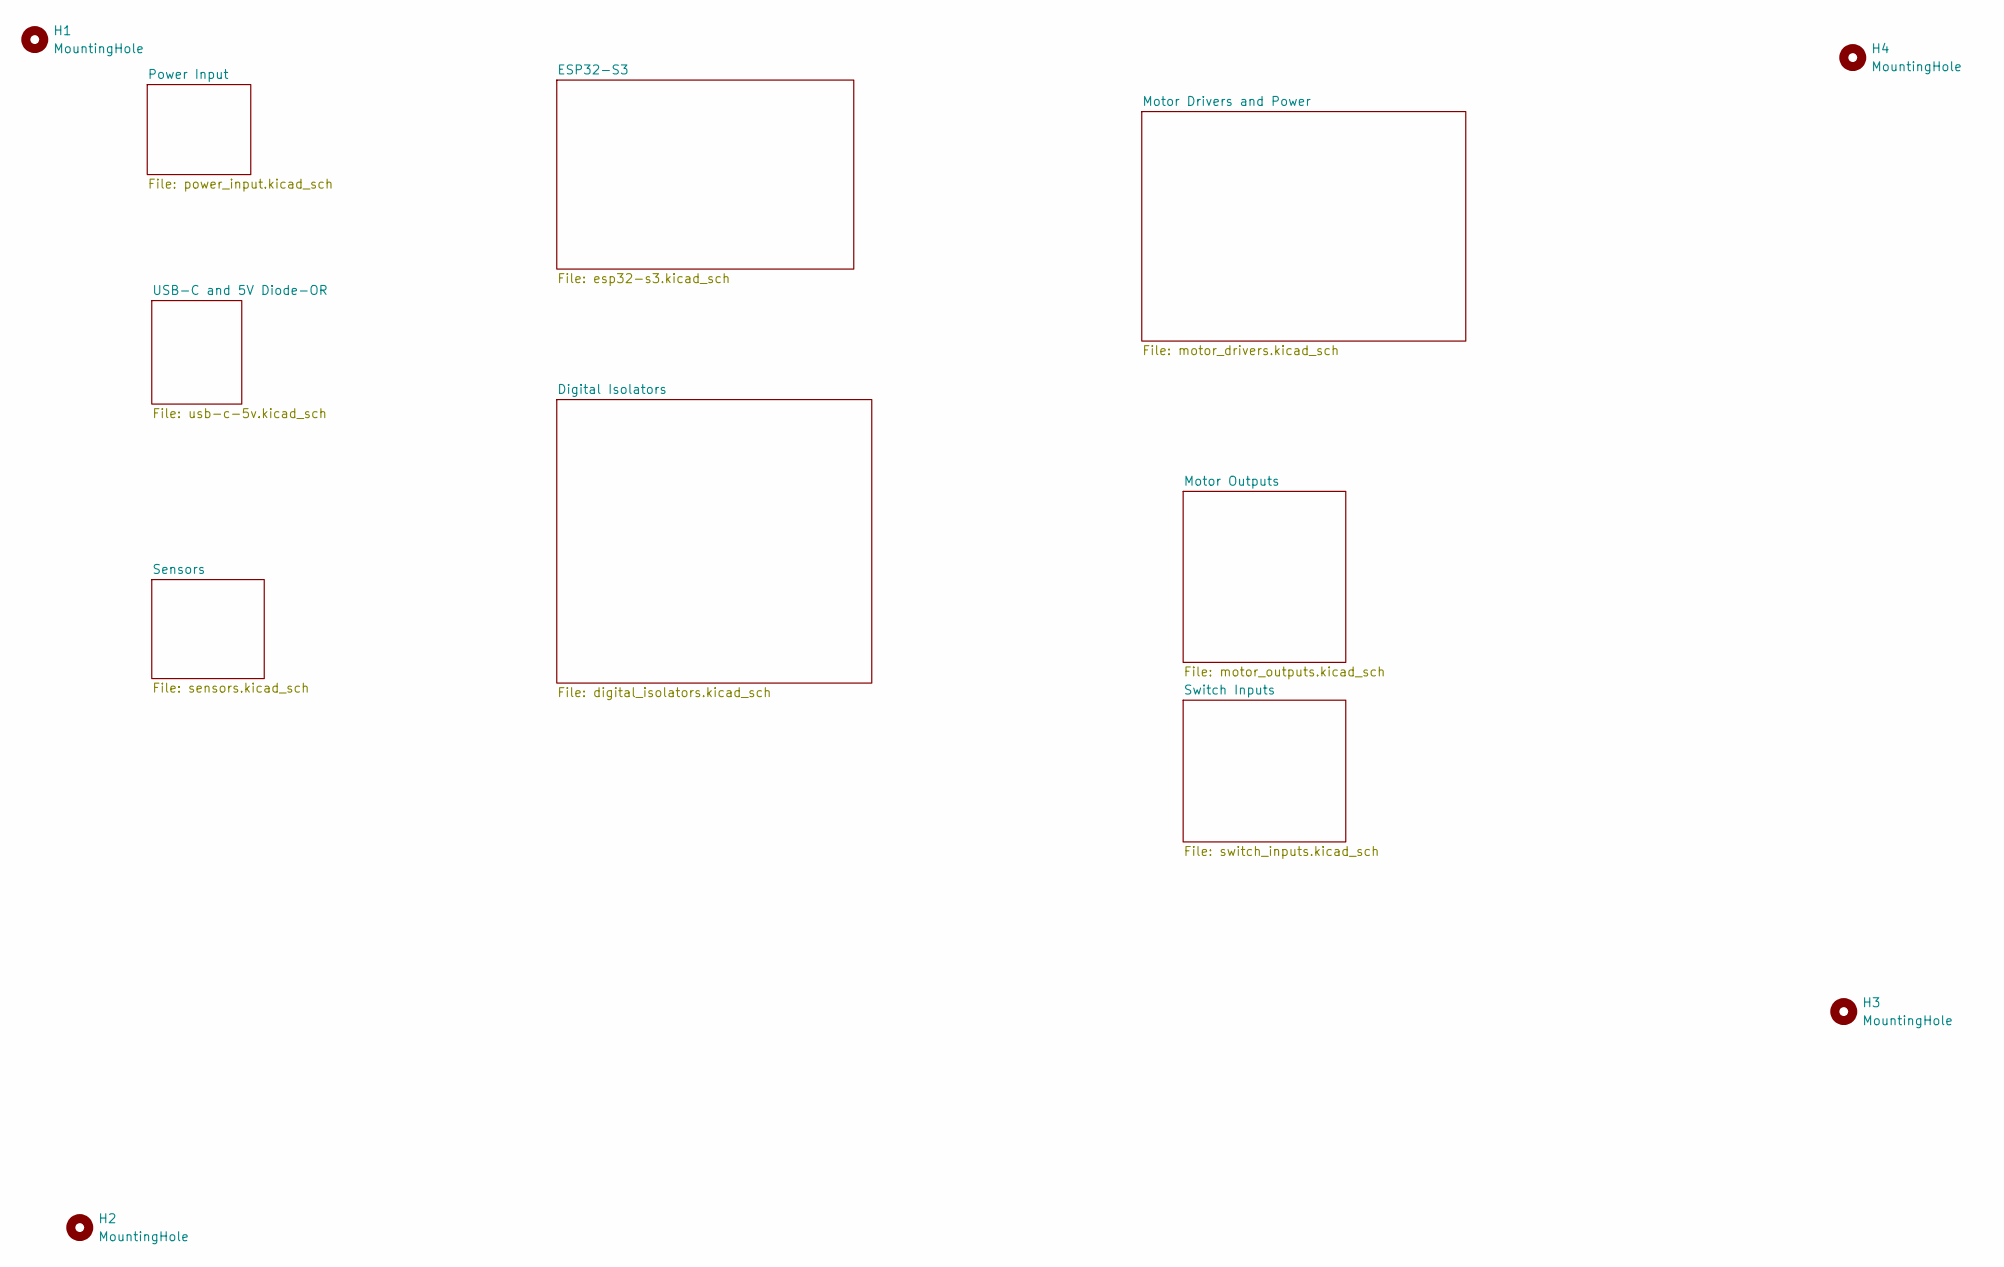
[picture p37: schematic barn-blinds-controller.kicad_sch]

Parts:
H1, H2, H3, H4: MountingHole; MountingHole_3.2mm_M3

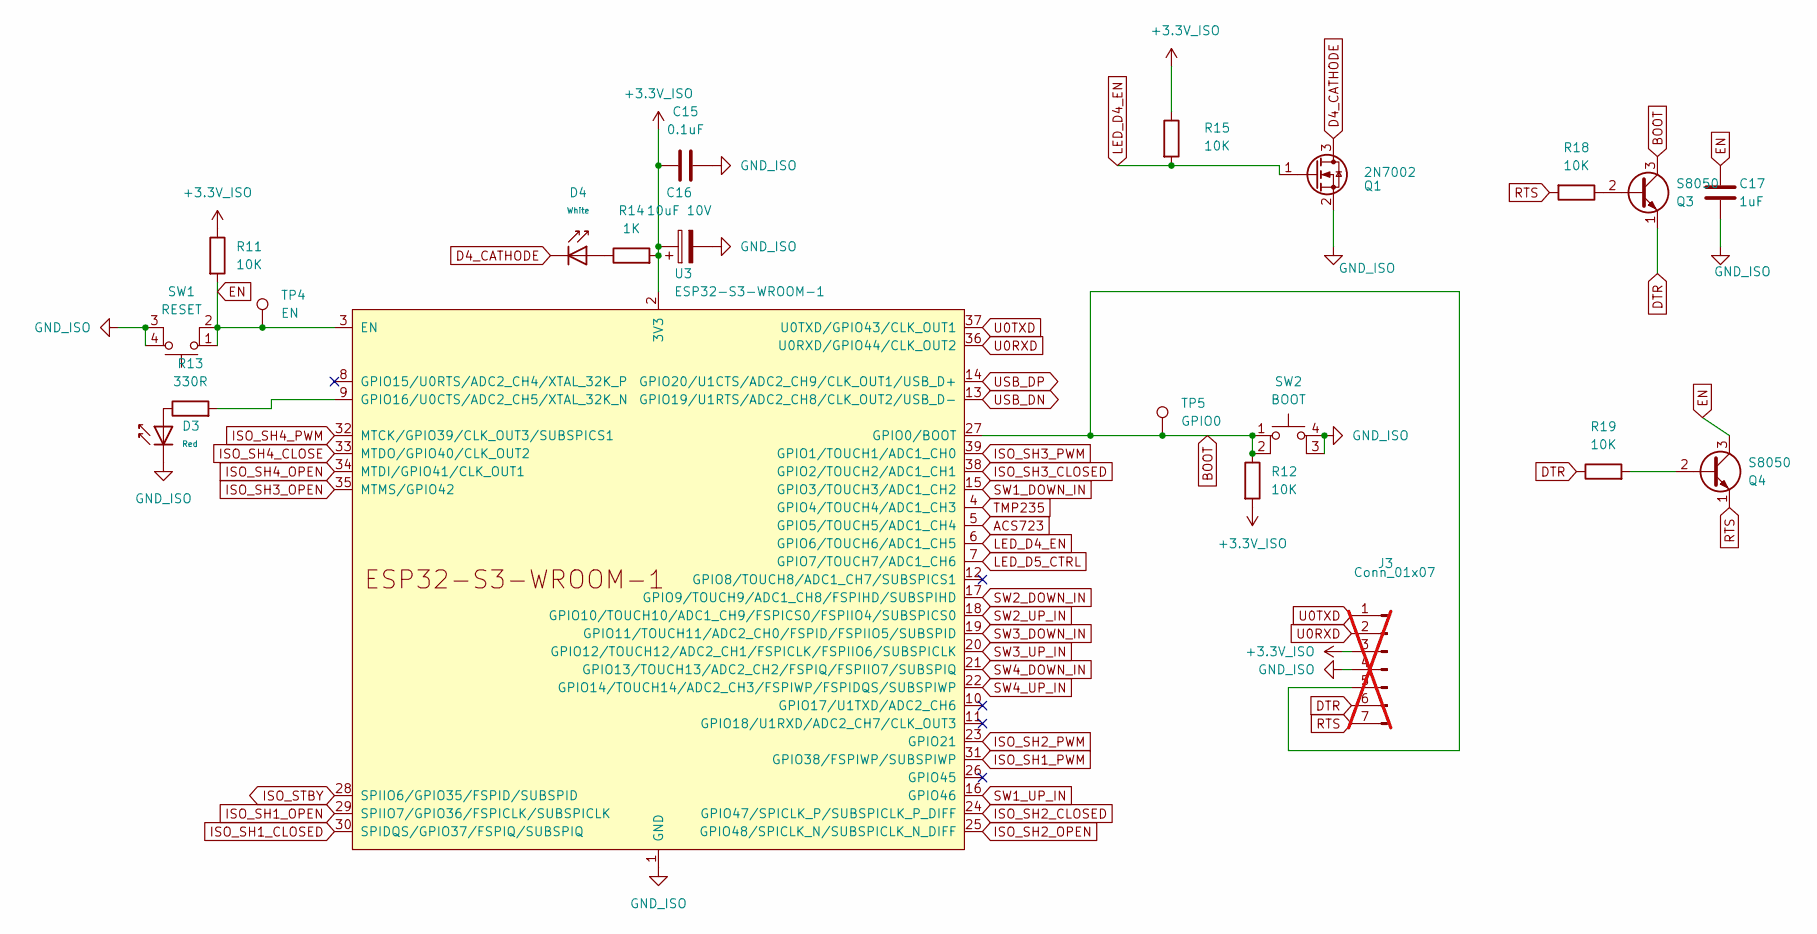
[picture p38: schematic esp32-s3.kicad_sch]

Parts:
C15: 0.1uF; C_0603_1608Metric; LCSC C1590
C16: 10uF 10V; C_0805_2012Metric; LCSC C17024
C17: 1uF; C_0603_1608Metric; LCSC C15849
D3: Red; D_0805_2012Metric; Forward Voltage (VF) 1.6V~2.6V; Part NCD0805R1; LCSC C84256
D4: White; D_0805_2012Metric; Forward Voltage (VF) 1.6V~2.6V; Part NCD0805R1; LCSC C84258
J3: Conn_01x07; PinHeader_1x07_P2.54mm_Vertical; LCSC C492404; not fitted
Q1: 2N7002; SOT-23; LCSC C8545
Q3, Q4: S8050; SOT-23; LCSC C2146
R11, R12, R15, R18, R19: 10K; R_0603_1608Metric; LCSC C25804
R13: 330R; R_0603_1608Metric; LCSC C23138
R14: 1K; R_0603_1608Metric; LCSC C14676
SW1: RESET; SW-SMD_4P-L3.5-W3.0-P1.50-LS4.7; LCSC C51927445
SW2: BOOT; SW-SMD_4P-L3.5-W3.0-P1.50-LS4.7; LCSC C51927445
TP4: EN; TestPoint_Pad_D1.0mm
TP5: GPIO0; TestPoint_Pad_D1.0mm
U3: ESP32-S3-WROOM-1; LCSC C2913197

Connections:
+3.3V_ISO: C15.1, C16.1, J3.3, R11.1, R12.2, R14.2, R15.1, U3.2 (3V3); also elsewhere on the board
ACS723: U3.5 (GPIO5/TOUCH5/ADC1_CH4); also elsewhere on the board
BOOT: J3.5, Q3.3 (C), R12.1, SW2.1, SW2.2, TP5.1 (1_1), U3.27 (GPIO0/BOOT)
D4_CATHODE: D4.1, Q1.3 (D)
DTR: J3.6, Q3.1 (E), R19.1
EN: C17.1, Q4.3 (C), R11.2, SW1.1, SW1.2, TP4.1 (1_1), U3.3 (EN)
GND_ISO: C15.2, C16.2, C17.2, D3.1, J3.4, Q1.2 (S), SW1.3 (K), SW1.4 (A), SW2.3 (K), SW2.4 (A), U3.1 (GND), U3.40 (GND), U3.41 (GND); also elsewhere on the board
ISO_SH1_CLOSED: U3.30 (SPIDQS/GPIO37/FSPIQ/SUBSPIQ); also elsewhere on the board
ISO_SH1_OPEN: U3.29 (SPIIO7/GPIO36/FSPICLK/SUBSPICLK); also elsewhere on the board
ISO_SH1_PWM: U3.31 (GPIO38/FSPIWP/SUBSPIWP); also elsewhere on the board
ISO_SH2_CLOSED: U3.24 (GPIO47/SPICLK_P/SUBSPICLK_P_DIFF); also elsewhere on the board
ISO_SH2_OPEN: U3.25 (GPIO48/SPICLK_N/SUBSPICLK_N_DIFF); also elsewhere on the board
ISO_SH2_PWM: U3.23 (GPIO21); also elsewhere on the board
ISO_SH3_CLOSED: U3.38 (GPIO2/TOUCH2/ADC1_CH1); also elsewhere on the board
ISO_SH3_OPEN: U3.35 (MTMS/GPIO42); also elsewhere on the board
ISO_SH3_PWM: U3.39 (GPIO1/TOUCH1/ADC1_CH0); also elsewhere on the board
ISO_SH4_CLOSE: U3.33 (MTDO/GPIO40/CLK_OUT2); also elsewhere on the board
ISO_SH4_OPEN: U3.34 (MTDI/GPIO41/CLK_OUT1); also elsewhere on the board
ISO_SH4_PWM: U3.32 (MTCK/GPIO39/CLK_OUT3/SUBSPICS1); also elsewhere on the board
ISO_STBY: U3.28 (SPIIO6/GPIO35/FSPID/SUBSPID); also elsewhere on the board
LED_D4_EN: Q1.1 (G), R15.2, U3.6 (GPIO6/TOUCH6/ADC1_CH5)
LED_D5_CTRL: U3.7 (GPIO7/TOUCH7/ADC1_CH6); also elsewhere on the board
unnamed: D3.2, R13.1
unnamed: D4.2, R14.1
unnamed: Q3.2 (B), R18.1
unnamed: Q4.2 (B), R19.2
unnamed: R13.2, U3.9 (GPIO16/U0CTS/ADC2_CH5/XTAL_32K_N)
RTS: J3.7, Q4.1 (E), R18.2
SW1_DOWN_IN: U3.15 (GPIO3/TOUCH3/ADC1_CH2); also elsewhere on the board
SW1_UP_IN: U3.16 (GPIO46); also elsewhere on the board
SW2_DOWN_IN: U3.17 (GPIO9/TOUCH9/ADC1_CH8/FSPIHD/SUBSPIHD); also elsewhere on the board
SW2_UP_IN: U3.18 (GPIO10/TOUCH10/ADC1_CH9/FSPICS0/FSPIIO4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); also elsewhere on the board
SW3_DOWN_IN: U3.19 (GPIO11/TOUCH11/ADC2_CH0/FSPID/FSPIIO5/S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); also elsewhere on the board
SW3_UP_IN: U3.20 (GPIO12/TOUCH12/ADC2_CH1/FSPICLK/FSPIIO6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); also elsewhere on the board
SW4_DOWN_IN: U3.21 (GPIO13/TOUCH13/ADC2_CH2/FSPIQ/FSPIIO7/S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); also elsewhere on the board
SW4_UP_IN: U3.22 (GPIO14/TOUCH14/ADC2_CH3/FSPIWP/FSPIDQS/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); also elsewhere on the board
TMP235: U3.4 (GPIO4/TOUCH4/ADC1_CH3); also elsewhere on the board
U0RXD: J3.2, U3.36 (U0RXD/GPIO44/CLK_OUT2)
U0TXD: J3.1, U3.37 (U0TXD/GPIO43/CLK_OUT1)
USB_DN: U3.13 (GPIO19/U1RTS/ADC2_CH8/CLK_OUT2/USB_D-); also elsewhere on the board
USB_DP: U3.14 (GPIO20/U1CTS/ADC2_CH9/CLK_OUT1/USB_D+); also elsewhere on the board

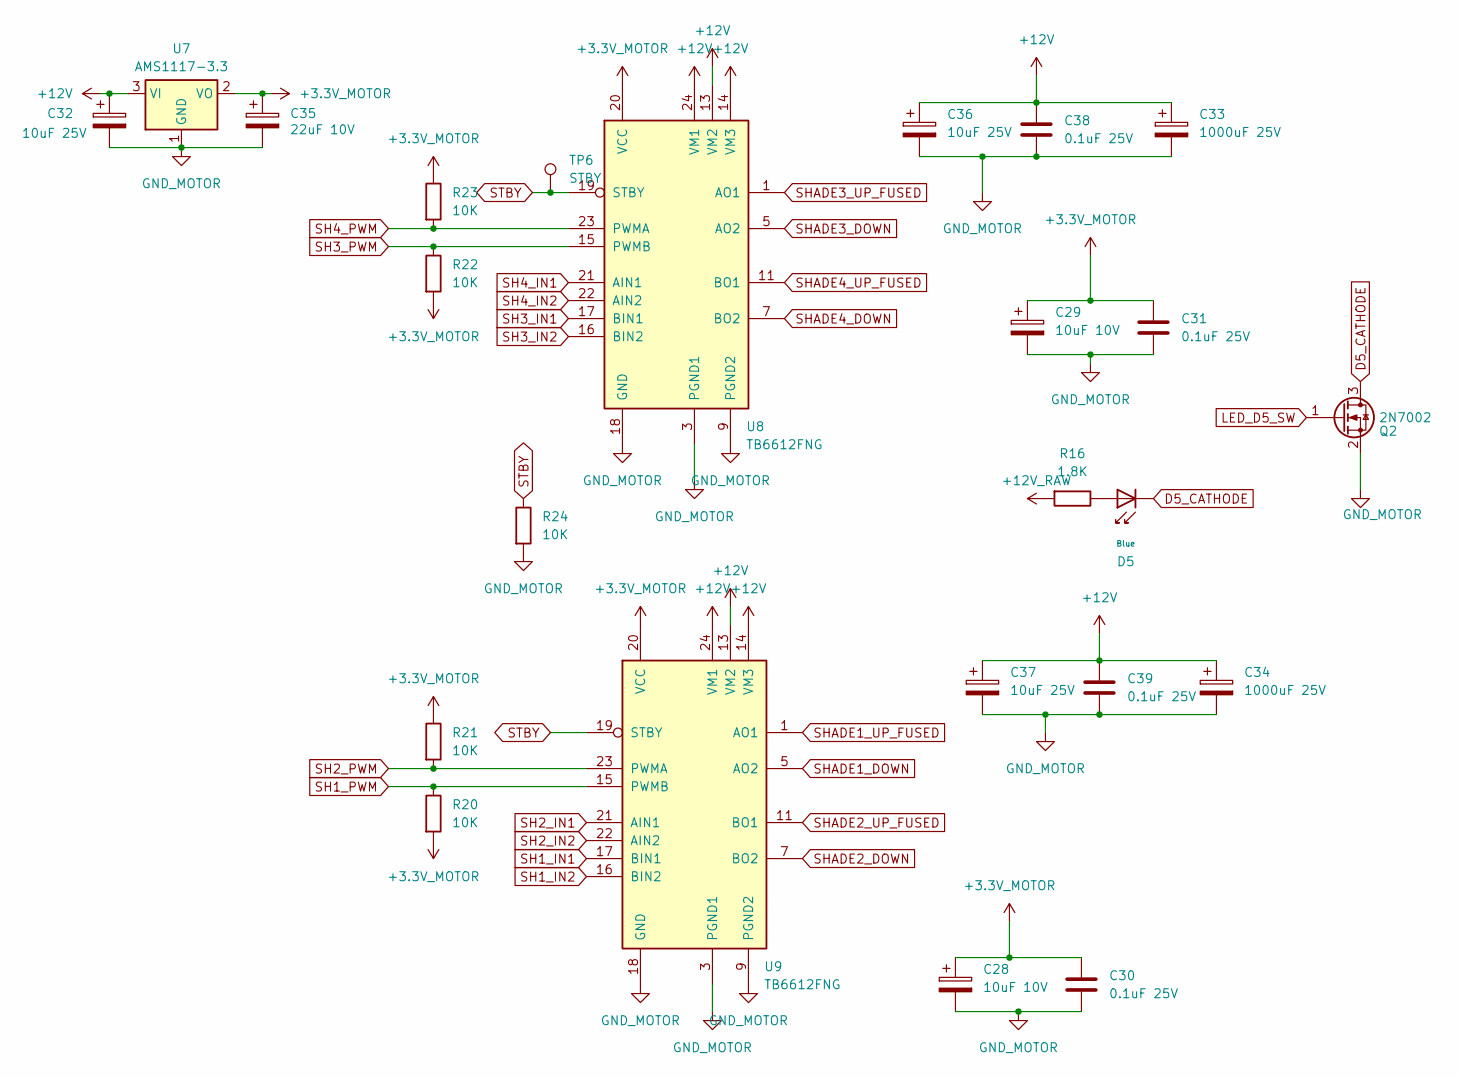
[picture p39: schematic motor_drivers.kicad_sch]

Parts:
C28, C29: 10uF 10V; C_0805_2012Metric; LCSC C17024
C30, C31, C38, C39: 0.1uF 25V; C_0603_1608Metric; LCSC C1590
C32, C36, C37: 10uF 25V; C_0805_2012Metric; LCSC C15850
C33, C34: 1000uF 25V; CP_Elec_10x10.5; PARTREV 10-Oct-19; LCSC C7471896
C35: 22uF 10V; C_0805_2012Metric; LCSC C29277
D5: Blue; D_0805_2012Metric; Forward Voltage (VF) 1.6V~2.6V; Part NCD0805R1; LCSC C2293
Q2: 2N7002; SOT-23; LCSC C8545
R16: 1.8K; R_0603_1608Metric; LCSC C4177
R20, R21, R22, R23, R24: 10K; R_0603_1608Metric; LCSC C25804
TP6: STBY; TestPoint_Pad_D1.0mm
U7: AMS1117-3.3; SOT-223-3_TabPin2; LCSC C6186
U8, U9: TB6612FNG; SSOP-24_5.3x8.2mm_P0.65mm; LCSC C88224

Connections:
+3.3V_MOTOR: C28.1, C29.1, C30.1, C31.1, C35.1, R20.2, R21.1, R22.2, R23.1, U7.2 (VO), U8.20 (VCC), U9.20 (VCC); also elsewhere on the board
+12V: C32.1, C33.1, C34.1, C36.1, C37.1, C38.1, C39.1, U7.3 (VI), U8.13 (VM2), U8.14 (VM3), U8.24 (VM1), U9.13 (VM2), U9.14 (VM3), U9.24 (VM1); also elsewhere on the board
+12V_RAW: R16.2; also elsewhere on the board
D5_CATHODE: D5.1, Q2.3 (D)
GND_MOTOR: C28.2, C29.2, C30.2, C31.2, C32.2, C33.2, C34.2, C35.2, C36.2, C37.2, C38.2, C39.2, Q2.2 (S), R24.2, U7.1 (GND), U8.3 (PGND1), U8.4 (PGND1), U8.9 (PGND2), U8.10 (PGND2), U8.18 (GND), U9.3 (PGND1), U9.4 (PGND1), U9.9 (PGND2), U9.10 (PGND2), U9.18 (GND); also elsewhere on the board
LED_D5_SW: Q2.1 (G); also elsewhere on the board
unnamed: D5.2, R16.1
SH1_IN1: U9.17 (BIN1); also elsewhere on the board
SH1_IN2: U9.16 (BIN2); also elsewhere on the board
SH1_PWM: R20.1, U9.15 (PWMB); also elsewhere on the board
SH2_IN1: U9.21 (AIN1); also elsewhere on the board
SH2_IN2: U9.22 (AIN2); also elsewhere on the board
SH2_PWM: R21.2, U9.23 (PWMA); also elsewhere on the board
SH3_IN1: U8.17 (BIN1); also elsewhere on the board
SH3_IN2: U8.16 (BIN2); also elsewhere on the board
SH3_PWM: R22.1, U8.15 (PWMB); also elsewhere on the board
SH4_IN1: U8.21 (AIN1); also elsewhere on the board
SH4_IN2: U8.22 (AIN2); also elsewhere on the board
SH4_PWM: R23.2, U8.23 (PWMA); also elsewhere on the board
SHADE1_DOWN: U9.5 (AO2), U9.6 (AO2); also elsewhere on the board
SHADE1_UP_FUSED: U9.1 (AO1), U9.2 (AO1); also elsewhere on the board
SHADE2_DOWN: U9.7 (BO2), U9.8 (BO2); also elsewhere on the board
SHADE2_UP_FUSED: U9.11 (BO1), U9.12 (BO1); also elsewhere on the board
SHADE3_DOWN: U8.5 (AO2), U8.6 (AO2); also elsewhere on the board
SHADE3_UP_FUSED: U8.1 (AO1), U8.2 (AO1); also elsewhere on the board
SHADE4_DOWN: U8.7 (BO2), U8.8 (BO2); also elsewhere on the board
SHADE4_UP_FUSED: U8.11 (BO1), U8.12 (BO1); also elsewhere on the board
STBY: R24.1, TP6.1 (1_1), U8.19 (STBY), U9.19 (STBY); also elsewhere on the board

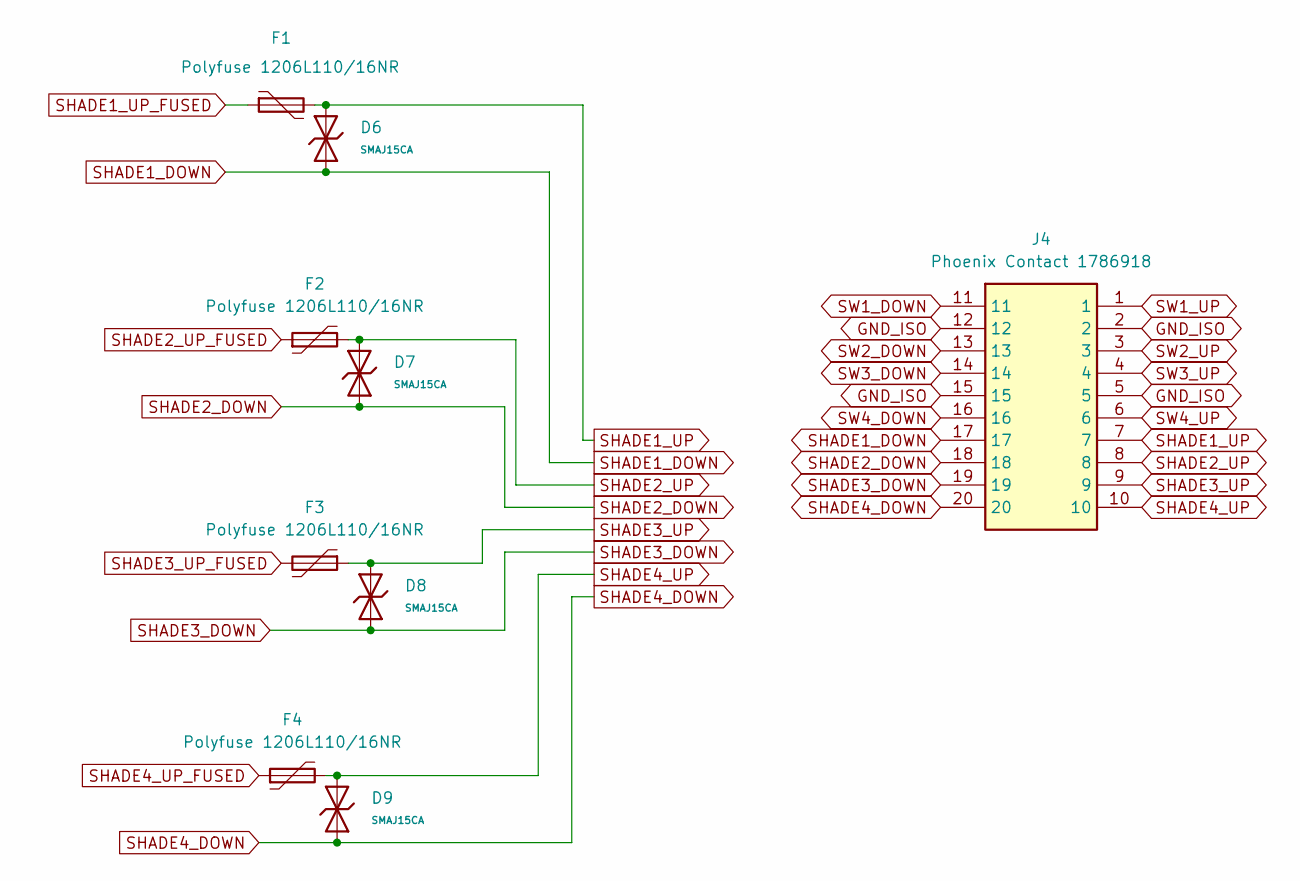
[picture p40: schematic motor_outputs.kicad_sch]

Parts:
D6, D7, D8, D9: SMAJ15CA; D_SMA; Clamping Voltage 19.9V; Voltage - Breakdown 13.3V; Part SMAJ15CA; LCSC C223985
F1, F2, F3, F4: Polyfuse 1206L110/16NR; Fuse_1206_3216Metric; LCSC C7542961
J4: Phoenix Contact 1786918; 1786918; Mouser Part Number 651-1786918

Connections:
GND_ISO: J4.2, J4.5, J4.12, J4.15; also elsewhere on the board
SHADE1_DOWN: D6.2, J4.17; also elsewhere on the board
SHADE1_UP: D6.1, F1.2, J4.7
SHADE1_UP_FUSED: F1.1; also elsewhere on the board
SHADE2_DOWN: D7.1, J4.18; also elsewhere on the board
SHADE2_UP: D7.2, F2.2, J4.8
SHADE2_UP_FUSED: F2.1; also elsewhere on the board
SHADE3_DOWN: D8.1, J4.19; also elsewhere on the board
SHADE3_UP: D8.2, F3.1, J4.9
SHADE3_UP_FUSED: F3.2; also elsewhere on the board
SHADE4_DOWN: D9.1, J4.20; also elsewhere on the board
SHADE4_UP: D9.2, F4.2, J4.10
SHADE4_UP_FUSED: F4.1; also elsewhere on the board
SW1_DOWN: J4.11; also elsewhere on the board
SW1_UP: J4.1; also elsewhere on the board
SW2_DOWN: J4.13; also elsewhere on the board
SW2_UP: J4.3; also elsewhere on the board
SW3_DOWN: J4.14; also elsewhere on the board
SW3_UP: J4.4; also elsewhere on the board
SW4_DOWN: J4.16; also elsewhere on the board
SW4_UP: J4.6; also elsewhere on the board

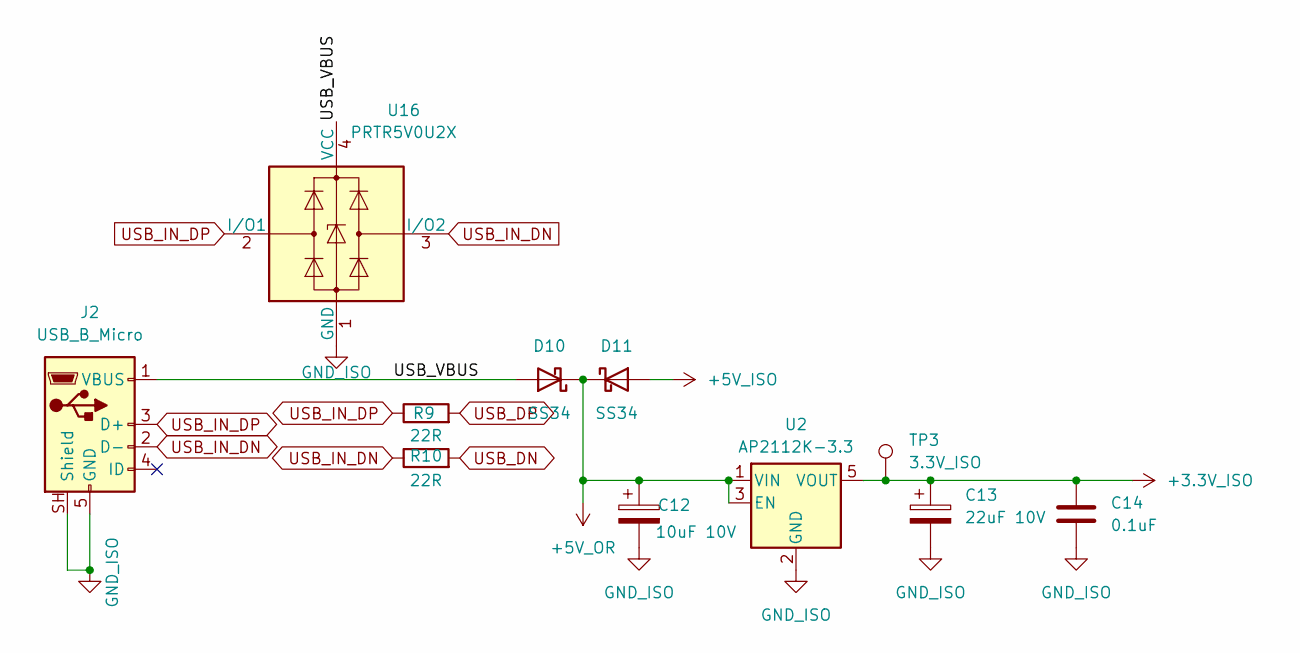
[picture p41: schematic usb-c-5v.kicad_sch]

Parts:
C12: 10uF 10V; C_0805_2012Metric; LCSC C17024
C13: 22uF 10V; C_0805_2012Metric; LCSC C29277
C14: 0.1uF; C_0603_1608Metric; LCSC C1590
D10, D11: SS34; D_SMA; LCSC C8678
J2: USB_B_Micro; USB_Micro-B_XKB_U254-051T-4BH83-F1S; LCSC C397452
R9, R10: 22R; R_0402_1005Metric; LCSC C25092
TP3: 3.3V_ISO; TestPoint_Pad_D1.0mm
U2: AP2112K-3.3; SOT-23-5; LCSC C23380830
U16: PRTR5V0U2X; SOT-143; LCSC C5158049

Connections:
+3.3V_ISO: C13.1, C14.1, TP3.1 (1_1), U2.5 (VOUT); also elsewhere on the board
+5V_ISO: D11.2 (A); also elsewhere on the board
+5V_OR: C12.1, D10.1 (K), D11.1 (K), U2.1 (VIN), U2.3 (EN)
/USB-C and 5V Diode-OR/USB_VBUS: D10.2 (A), J2.1 (VBUS), U16.4 (VCC)
GND_ISO: C12.2, C13.2, C14.2, J2.5 (GND), J2.SH (Shield), U2.2 (GND), U16.1 (GND); also elsewhere on the board
USB_DN: R10.2; also elsewhere on the board
USB_DP: R9.2; also elsewhere on the board
USB_IN_DN: J2.2 (D-), R10.1, U16.3 (I/O2)
USB_IN_DP: J2.3 (D+), R9.1, U16.2 (I/O1)

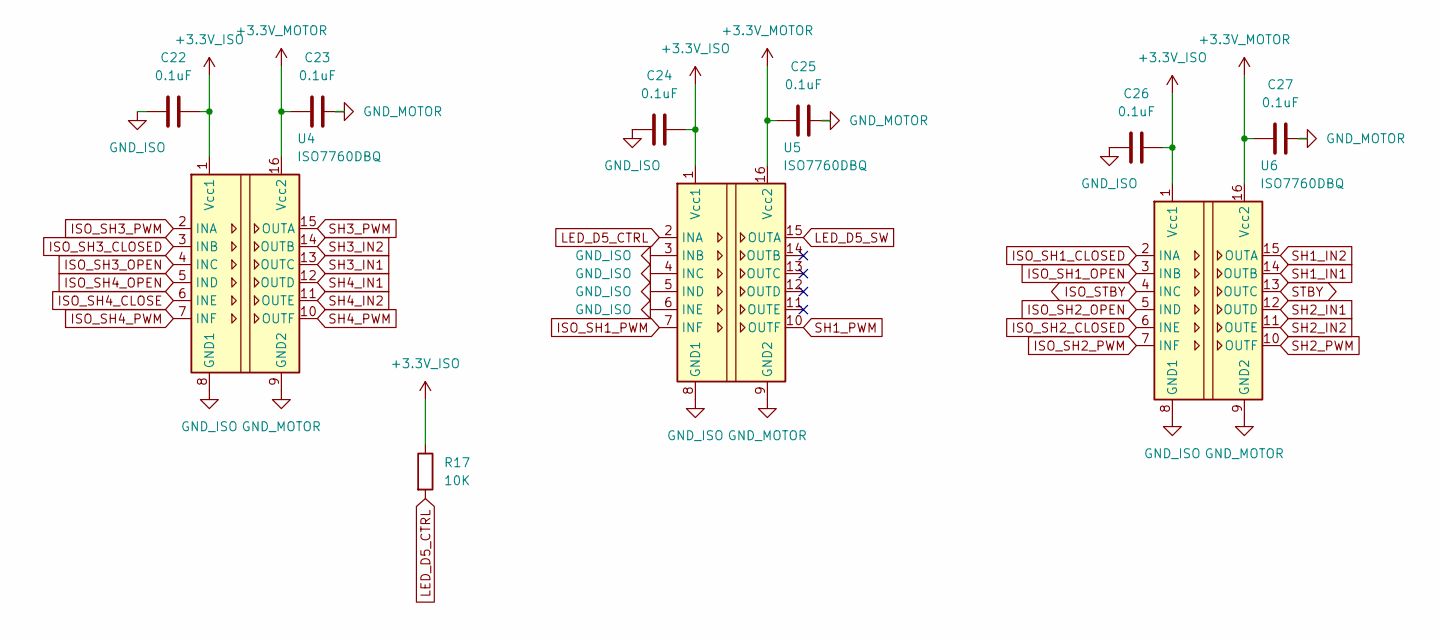
[picture p42: schematic digital_isolators.kicad_sch]

Parts:
C22, C23, C24, C25, C26, C27: 0.1uF; C_0603_1608Metric; LCSC C1590
R17: 10K; R_0603_1608Metric; LCSC C25804
U4, U5, U6: ISO7760DBQ; SSOP-16_3.9x4.9mm_P0.635mm; LCSC C2868628

Connections:
+3.3V_ISO: C22.2, C24.2, C26.2, R17.1, U4.1 (Vcc1), U5.1 (Vcc1), U6.1 (Vcc1); also elsewhere on the board
+3.3V_MOTOR: C23.1, C25.1, C27.1, U4.16 (Vcc2), U5.16 (Vcc2), U6.16 (Vcc2); also elsewhere on the board
GND_ISO: C22.1, C24.1, C26.1, U4.8 (GND1), U5.3 (INB), U5.4 (INC), U5.5 (IND), U5.6 (INE), U5.8 (GND1), U6.8 (GND1); also elsewhere on the board
GND_MOTOR: C23.2, C25.2, C27.2, U4.9 (GND2), U5.9 (GND2), U6.9 (GND2); also elsewhere on the board
ISO_SH1_CLOSED: U6.2 (INA); also elsewhere on the board
ISO_SH1_OPEN: U6.3 (INB); also elsewhere on the board
ISO_SH1_PWM: U5.7 (INF); also elsewhere on the board
ISO_SH2_CLOSED: U6.6 (INE); also elsewhere on the board
ISO_SH2_OPEN: U6.5 (IND); also elsewhere on the board
ISO_SH2_PWM: U6.7 (INF); also elsewhere on the board
ISO_SH3_CLOSED: U4.3 (INB); also elsewhere on the board
ISO_SH3_OPEN: U4.4 (INC); also elsewhere on the board
ISO_SH3_PWM: U4.2 (INA); also elsewhere on the board
ISO_SH4_CLOSE: U4.6 (INE); also elsewhere on the board
ISO_SH4_OPEN: U4.5 (IND); also elsewhere on the board
ISO_SH4_PWM: U4.7 (INF); also elsewhere on the board
ISO_STBY: U6.4 (INC); also elsewhere on the board
LED_D5_CTRL: R17.2, U5.2 (INA); also elsewhere on the board
LED_D5_SW: U5.15 (OUTA); also elsewhere on the board
SH1_IN1: U6.14 (OUTB); also elsewhere on the board
SH1_IN2: U6.15 (OUTA); also elsewhere on the board
SH1_PWM: U5.10 (OUTF); also elsewhere on the board
SH2_IN1: U6.12 (OUTD); also elsewhere on the board
SH2_IN2: U6.11 (OUTE); also elsewhere on the board
SH2_PWM: U6.10 (OUTF); also elsewhere on the board
SH3_IN1: U4.13 (OUTC); also elsewhere on the board
SH3_IN2: U4.14 (OUTB); also elsewhere on the board
SH3_PWM: U4.15 (OUTA); also elsewhere on the board
SH4_IN1: U4.12 (OUTD); also elsewhere on the board
SH4_IN2: U4.11 (OUTE); also elsewhere on the board
SH4_PWM: U4.10 (OUTF); also elsewhere on the board
STBY: U6.13 (OUTC); also elsewhere on the board

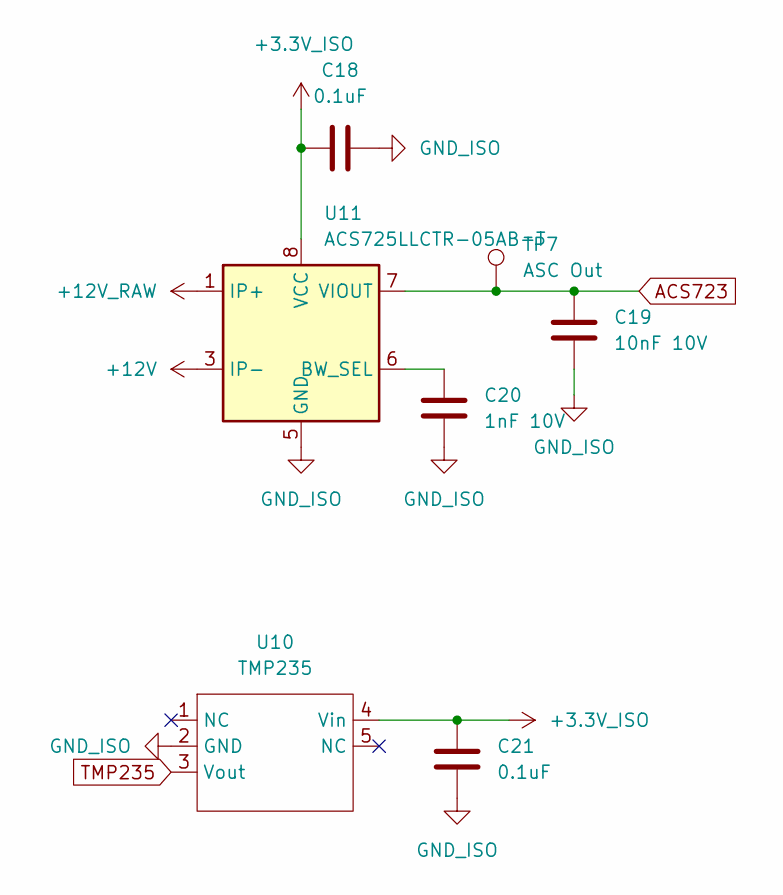
[picture p43: schematic sensors.kicad_sch]

Parts:
C18, C21: 0.1uF; C_0603_1608Metric; LCSC C1590
C19: 10nF 10V; C_0603_1608Metric; LCSC C519405
C20: 1nF 10V; C_0603_1608Metric; LCSC C519402
TP7: ASC Out; TestPoint_Pad_D1.0mm
U10: TMP235; SOT-353_SC-70-5; LCSC C2861437
U11: ACS725LLCTR-05AB-T; SOIC-8_3.9x4.9mm_P1.27mm; LCSC C3684552

Connections:
+3.3V_ISO: C18.1, C21.1, U10.4 (Vin), U11.8 (VCC); also elsewhere on the board
+12V: U11.3 (IP-), U11.4 (IP-); also elsewhere on the board
+12V_RAW: U11.1 (IP+), U11.2 (IP+); also elsewhere on the board
ACS723: C19.1, TP7.1 (1_1), U11.7 (VIOUT); also elsewhere on the board
GND_ISO: C18.2, C19.2, C20.2, C21.2, U10.2 (GND), U11.5 (GND); also elsewhere on the board
unnamed: C20.1, U11.6 (BW_SEL)
TMP235: U10.3 (Vout); also elsewhere on the board

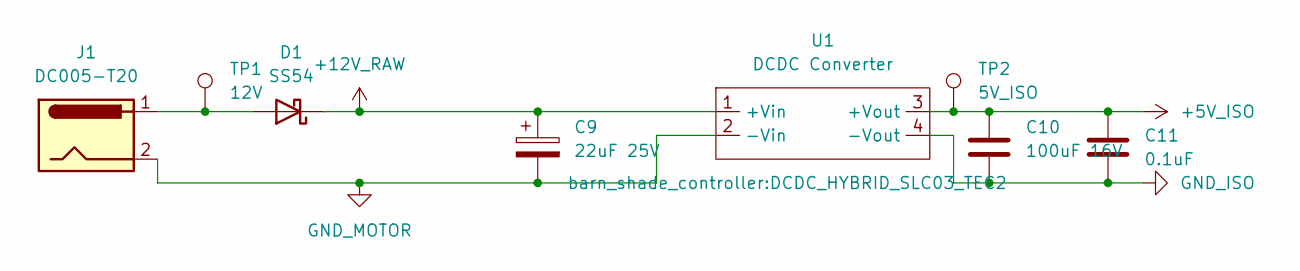
[picture p44: schematic power_input.kicad_sch]

Parts:
C9: 22uF 25V; C_0805_2012Metric; LCSC C45783
C10: 100uF 16V; C_1210_3225Metric; LCSC C7432790
C11: 0.1uF; C_0603_1608Metric; LCSC C1590
D1: SS54; D_SMA; LCSC C22452
J1: DC005-T20; BarrelJack_Horizontal; LCSC C111567
TP1: 12V; TestPoint_Pad_D1.0mm
TP2: 5V_ISO; TestPoint_Pad_D1.0mm
U1: DCDC Converter; DCDC_HYBRID_SLC03_TEC2; LCSC C20622657

Connections:
+5V_ISO: C10.1, C11.1, TP2.1 (1_1), U1.3 (+Vout); also elsewhere on the board
+12V_RAW: C9.1, D1.1 (K), U1.1 (+Vin); also elsewhere on the board
GND_ISO: C10.2, C11.2, U1.4 (-Vout); also elsewhere on the board
GND_MOTOR: C9.2, J1.2, U1.2 (-Vin); also elsewhere on the board
unnamed: D1.2 (A), J1.1, TP1.1 (1_1)

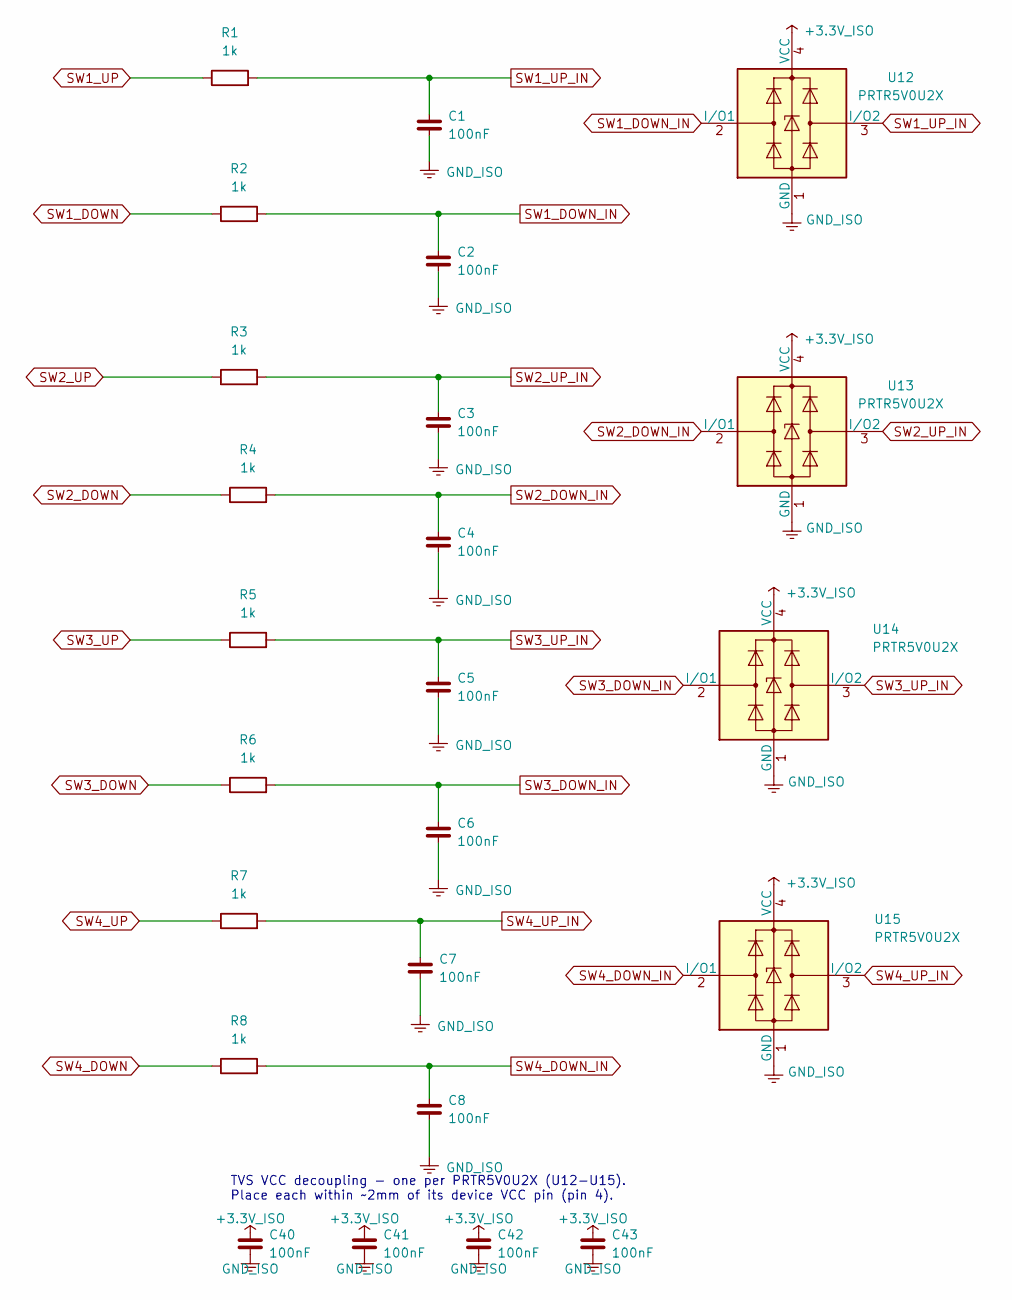
[picture p45: schematic switch_inputs.kicad_sch, Switch Input Protection]

Parts:
C1, C2, C3, C4, C5, C6, C7, C8, C40, C41, C42, C43: 100nF; C_0402_1005Metric; LCSC C1525
R1, R2, R3, R4, R5, R6, R7, R8: 1k; R_0603_1608Metric; LCSC C14676
U12, U13, U14, U15: PRTR5V0U2X; SOT-143; LCSC C5158049

Connections:
+3.3V_ISO: C40.1, C41.1, C42.1, C43.1, U12.4 (VCC), U13.4 (VCC), U14.4 (VCC), U15.4 (VCC); also elsewhere on the board
GND_ISO: C1.2, C2.2, C3.2, C4.2, C5.2, C6.2, C7.2, C8.2, C40.2, C41.2, C42.2, C43.2, U12.1 (GND), U13.1 (GND), U14.1 (GND), U15.1 (GND); also elsewhere on the board
SW1_DOWN: R2.1; also elsewhere on the board
SW1_DOWN_IN: C2.1, R2.2, U12.2 (I/O1); also elsewhere on the board
SW1_UP: R1.1; also elsewhere on the board
SW1_UP_IN: C1.1, R1.2, U12.3 (I/O2); also elsewhere on the board
SW2_DOWN: R4.1; also elsewhere on the board
SW2_DOWN_IN: C4.1, R4.2, U13.2 (I/O1); also elsewhere on the board
SW2_UP: R3.1; also elsewhere on the board
SW2_UP_IN: C3.1, R3.2, U13.3 (I/O2); also elsewhere on the board
SW3_DOWN: R6.1; also elsewhere on the board
SW3_DOWN_IN: C6.1, R6.2, U14.2 (I/O1); also elsewhere on the board
SW3_UP: R5.1; also elsewhere on the board
SW3_UP_IN: C5.1, R5.2, U14.3 (I/O2); also elsewhere on the board
SW4_DOWN: R8.1; also elsewhere on the board
SW4_DOWN_IN: C8.1, R8.2, U15.2 (I/O1); also elsewhere on the board
SW4_UP: R7.1; also elsewhere on the board
SW4_UP_IN: C7.1, R7.2, U15.3 (I/O2); also elsewhere on the board

Notes on the sheet:
TVS VCC decoupling - one per PRTR5V0U2X (U12-U15). Place each within ~2mm of its device VCC pin (pin 4).

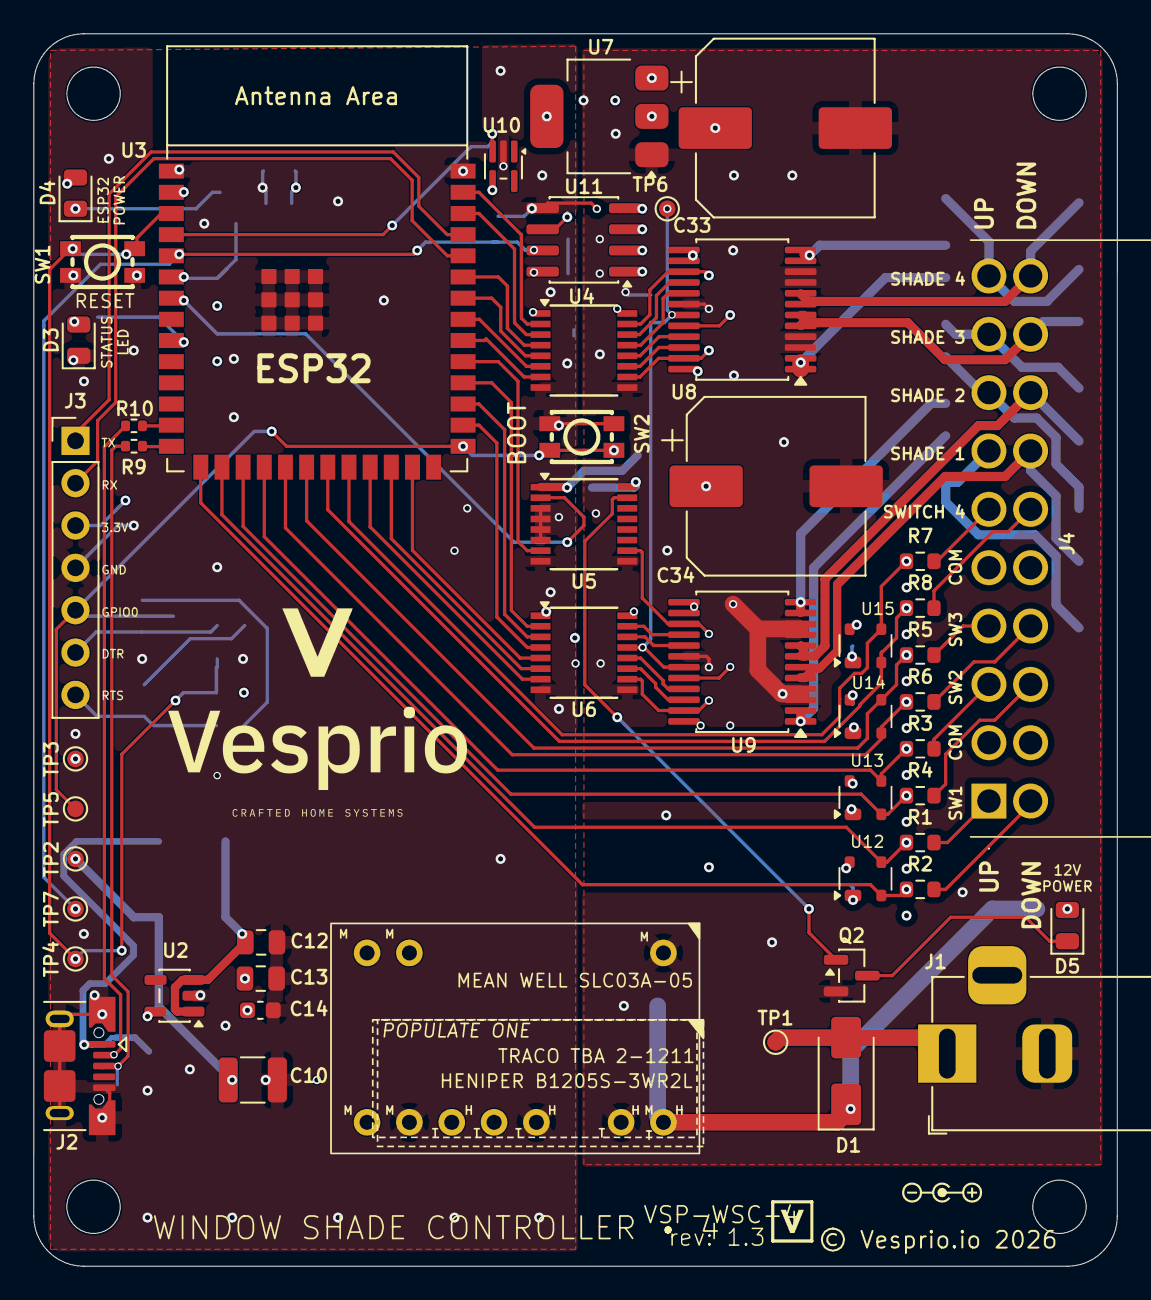
[picture p46: board barn-blinds-controller.kicad_pcb from above]

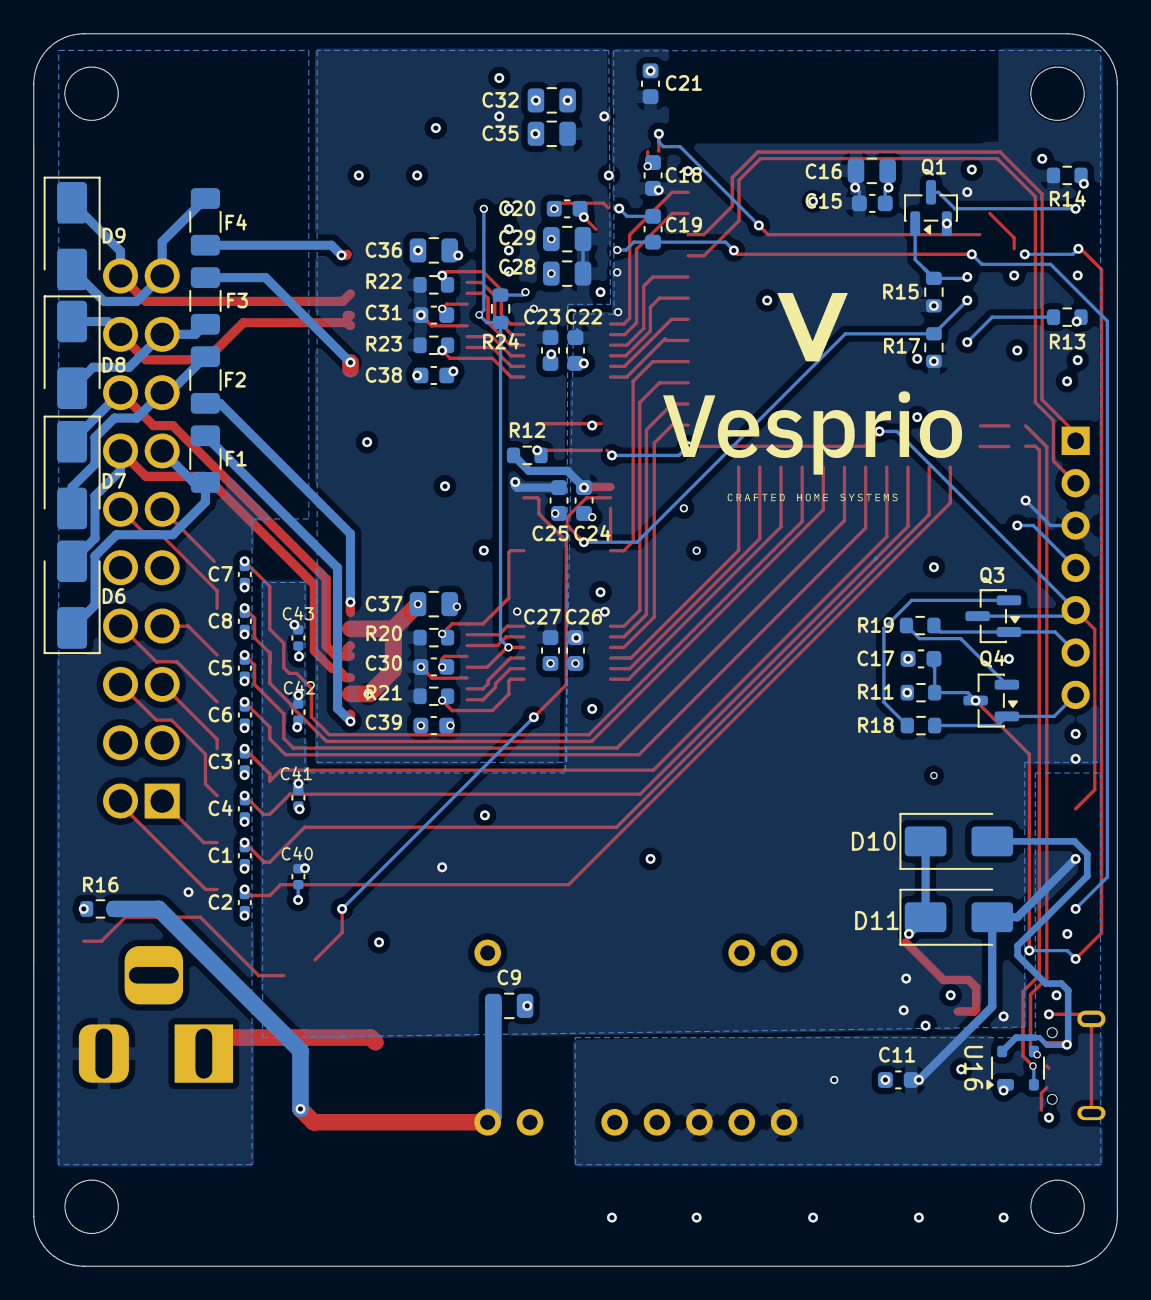
[picture p47: board barn-blinds-controller.kicad_pcb from below]

Board: 4 copper layers, 65.0 x 73.9 mm, 118 parts (65 on the bottom side), 88 nets.
