irvintim/barn-blinds-controller/(commit log)

2026-04-15 Updated capacitor direction
    [barn-blinds-controller.kicad_sch]
2026-04-15 Added hierarchical sheets for custom pcb design
    [barn-blinds-controller.kicad_sch, power_input.kicad_sch]
2026-04-16 adding DCDC converter symbol and footprint
2026-04-17 adding hierachical sheets: Isolated circuits, esp32, etc
    [barn-blinds-controller.kicad_sch, digital_isolators.kicad_sch, esp32-s3.kicad_sch, power_input.kicad_sch, usb-c-5v.kicad_sch]
2026-04-18 Started running traces
    [barn-blinds-controller.kicad_pcb, barn-blinds-controller.kicad_sch, digital_isolators.kicad_sch, esp32-s3.kicad_sch, power_input.kicad_sch, usb-c-5v.kicad_sch]
2026-04-19 PCB tracing complete
    [barn-blinds-controller.kicad_pcb, barn-blinds-controller.kicad_sch, digital_isolators.kicad_sch, esp32-s3.kicad_sch]
2026-04-20 Reworking with new terminal block, adding mounting holes. Need to rerun a number of traces.
    [barn-blinds-controller.kicad_pcb, barn-blinds-controller.kicad_sch]
2026-04-21 Finishing touches
    [EDI2CAP.CFG, KH-TYPE-C-16P.step, SLC03A-05.stp, barn-blinds-controller.kicad_pcb, chips.prt, motor_drivers.kicad_sch, motor_outputs.kicad_sch, sensors.kicad_sch]
2026-04-22 Remove KiCad cache/backup files and add .gitignore
2026-04-23 BOM work
    [EEVTG2A221M.STEP, JLCPCB_BOM_Template.xls, barn-blinds-controller.kicad_sch, digital_isolators.kicad_sch, esp32-s3.kicad_sch, motor_drivers.kicad_sch, motor_outputs.kicad_sch, power_input.kicad_sch]
2026-04-23 Added BOM
    [barn-blinds-controller.csv]
2026-04-23 Updated BOM, fixed a few components
    [barn-blinds-controller.csv, motor_outputs.kicad_sch, power_input.kicad_sch, usb-c-5v.kicad_sch]
2026-04-23 Replaced fuses and rearranged to fit better
    [barn-blinds-controller.kicad_pcb]
2026-04-23 3d model for 8 port connector
    [JL217R-35008G01-BodyPad001.step, JL217R-35008G01-BodyPad001.stl, JL271R-35008G01.FCStd]
2026-04-23 Updated connector to match actual footprint, updated 3D images.
    [barn-blinds-controller.kicad_pcb]
2026-04-24 Final cleanup
    [Unnamed-PCB_Compound (Meshed).stl, barn-blinds-controller.kicad_pcb, barn-blinds-controller.kicad_sch]
2026-04-24 Sent for production
    [JL217R-35008G01-BodyPad001.step, JL271R-35008G01-BodyPad001.stl, JL271R-35008G01.FCStd, Unnamed-PCB_Compound.step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]
2026-04-28 Refactored board to use larger vias and route better paths.
    [barn-blinds-controller.csv, barn-blinds-controller.kicad_pcb, digital_isolators.kicad_sch, esp32-s3.kicad_sch, motor_drivers.kicad_sch, motor_outputs.kicad_sch]
2026-04-28 Added revision text to board
    [barn-blinds-controller.kicad_pcb]
2026-06-11 V 1.2
    [barn-blinds-controller.kicad_pcb, barn-blinds-controller.kicad_sch, barn-blinds-controller.step, esp32-s3.kicad_sch, motor_drivers.kicad_sch, motor_outputs.kicad_sch, power_input.kicad_sch, sensors.kicad_sch]
2026-06-12 1st pass at Claude adding new input circuits.
    [1054070.psm, 1787470.psm, 1787470.stp, 1790373.stp, EDI2CAP.CFG, chips.prt]
2026-06-28 Rev 1.3 updates
    [barn-blinds-controller.kicad_sch, motor_outputs.kicad_sch]
2026-06-30 DIN rail options.
    [1597DIN2GY.stp]
2026-06-30 added switch_inputs
    [switch_inputs.kicad_sch]
2026-06-30 added power_icon
2026-07-01 Updated USB to switch from USB-C to Micro
    [barn-blinds-controller.kicad_sch, motor_outputs.kicad_sch, switch_inputs.kicad_sch, usb-c-5v.kicad_sch]
2026-07-06 Updating routing with new terminal block
    [1054070.stp, barn-blinds-controller.kicad_pcb, motor_outputs.kicad_sch, power_input.kicad_sch, switch_inputs.kicad_sch]
2026-07-06 Adding switches to PCB
    [barn-blinds-controller.kicad_pcb, esp32-s3.kicad_sch, switch_inputs.kicad_sch]
2026-07-06 Completed added switch circuits
    [barn-blinds-controller.kicad_pcb, esp32-s3.kicad_sch]
2026-07-06 Version bump
    [barn-blinds-controller.kicad_pcb]
2026-07-06 Add 1786918/1790182 ECAD libraries, fix stale J2/J4 3D model paths
    J4 was already using the 1786918 (right-angle socket) footprint in the
    schematic, but its Samacsys-downloaded library folders and 3D models
    were never committed, so exports only worked on hosts that still had
    the local download cache. Same issue for J2's USB Micro-B model, which
    was pointing at an absolute path into a sibling repo (zen32-esphome).
    [1786918.PcbLib, 1786918.SchLib, 1786918.psm, 1786918.stp, 1790182.stp, EDI2CAP.CFG, barn-blinds-controller.kicad_pcb, chips.prt]
2026-07-06 Fix SW1/SW2 3D model: replace oversized CDFER placeholder with correct GCT switch
    The SW-SMD_4P-L3.5-W3.0-P1.50-LS4.7 footprint (MEC 5E tactile switch,
    LCSC C51927445) had correct pads but was using CDFER's only SW-SMD_4P
    3D model as a placeholder, which belongs to a much larger 5.1x5.1mm
    switch. Borrowed the correct GCT SWT0115-020025SSA model (3.50x3.10mm,
    matching physical size) from the zen32-esphome project, which already
    uses the same switch.
    [SWT0115-020025SSA_revA.STEP, barn-blinds-controller.kicad_pcb]
2026-07-07 Added RTS/DTS programing via UART circuitry, added LED control circuitry.
    [barn-blinds-controller.kicad_pcb, digital_isolators.kicad_sch, esp32-s3.kicad_sch, motor_drivers.kicad_sch, motor_outputs.kicad_sch]
2026-07-07 Update annotations, fixed font sizes.
    [barn-blinds-controller.kicad_pcb, digital_isolators.kicad_sch, esp32-s3.kicad_sch, motor_drivers.kicad_sch, motor_outputs.kicad_sch, power_input.kicad_sch, sensors.kicad_sch, switch_inputs.kicad_sch]
2026-07-07 Cleaned up annotations on board.
    [barn-blinds-controller.kicad_pcb]
2026-07-08 Pre-fab QA review fixes: switch input levels, power path, sensor spec, ESD
    - R1-R8 switch series resistors 10k -> 1k: with only the ESP32 internal
    ~45k pull-up, 10k divided a closed switch to 0.6V vs the S3's 0.825V
    VIL limit — marginal. 1k gives ~0.1-0.23V worst case.
    - U11 ACS723 -> ACS725LLCTR-05AB-T (C3684552): ACS723 needs 4.5-5.5V but
    ran at 3.3V (out of spec). ACS725 is 3.3V-native, same SOIC-8, rated
    to +150C. Firmware: sensitivity 264mV/A, formula (x-1.65)/0.264.
    - D2 BAT54C (200mA) removed; replaced with D10/D11 SS34 (3A) diode-OR.
    The old diode carried the full ESP32 load permanently; WiFi TX bursts
    reach 350-500mA.
    - U16 PRTR5V0U2X added on USB D+/D- (ESD protection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
    [esp32-s3.kicad_sch, motor_drivers.kicad_sch, power_input.kicad_sch, sensors.kicad_sch, switch_inputs.kicad_sch, usb-c-5v.kicad_sch]
2026-07-08 Repo cleanup: commit missing sources, untrack per-user/scratch files
    Added: autoexec.be (Tasmota Berry script), FreeCAD sources
    (barn-blinds-controller/project-case/B1205S-3WR2L .FCStd), v1.1
    BOM/CPL fab records, v1.1 gerbers, production BOM/CPL/inventory,
    project footprints (1786918, no-mask test point), enclosure print
    files, license/version for Tasmota filesystem upload.
    Untracked (kept on disk): barn-blinds-controller.kicad_prl (per-user
    KiCad prefs — caused phantom diffs across machines), pcb_1.step and
    Unnamed-* export scratch.
    .gitignore now covers KiCad/FreeCAD backups, IDE state, lock files,
    backup folders, and the Espressif PCM library (install per machine
    via Plugin & Content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
    [B1205S-3WR2L-BodyPad001.step, B1205S-3WR2L-BodySketch001.step, B1205S-3WR2L.FCStd, Parts Inventory on JLCPCB.csv, Parts Inventory on JLCPCB.xlsx, R15P23.3S_X2_P_R6.4--3DModel-STEP-510211.STEP, Unnamed-Component_Compound (Meshed).stl, Unnamed-Component_Compound (Meshed)_fixed.stl]
2026-08-07 Rev 1.3 PCB sync + second QA pass: BOM fixes, TVS decoupling, ERC cleanup
    PCB (done in KiCad, verified here):
    - F8 sync applied: D2 removed; D10/D11 (SS34 SMA) and U16 (PRTR5V0U2X SOT-143)
    placed and routed; R1-R8 -> 1k, D1 -> SS54, C10 -> 25V, U11 -> ACS725 updated
    in place. Footprint-level diff confirms exactly the intended delta, nothing
    else moved. DRC 0 errors / 0 unconnected pads.
    Schematic fixes from the second QA pass:
    - R1-R8 had NO LCSC part number (value change had landed, part number never
    did) - they would have come back unpopulated, silently killing the switch
    inputs. Set to C14676, matching R14's existing 1K 0603 so it consolidates to
    one BOM line. NOTE: todo.md o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
    [barn-blinds-controller.kicad_pcb, esp32-s3.kicad_sch, motor_drivers.kicad_sch, power_input.kicad_sch, sensors.kicad_sch, switch_inputs.kicad_sch, usb-c-5v.kicad_sch]
2026-08-07 Rev 1.3 fab-ready: PICK UP HERE items closed, JLCPCB production files generated
    PCB (verified via DRC/ERC/netlist diff, not just eyeballed):
    - Placed C40-C43 within ~1.8-2.6mm of each PRTR5V0U2X VCC pin (U12-U15).
    - Widened +5V_OR to 0.5mm and USB_VBUS to 0.4mm.
    - Moved U16 closer to J2 (center-to-center 6.1mm -> 4.0mm). Still on B.Cu
    vs J2's F.Cu, so the D+/D- path still crosses layers via a short stub -
    accepted trade-off for a Full-Speed, occasional-use flashing port.
    - Fixed D10/D11 silkscreen reference overlap.
    - Added LCSC to J2 (C397452, Micro-USB) and J4 (C6652293 - pre-purchased
    JLCPCB inventory part; number is still required for JLCPCB to place it).
    DRC: 0 unconnected pads,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
    [VSP-WSC-4_1.3_bom.csv, VSP-WSC-4_1.3_designators.csv, VSP-WSC-4_1.3_positions.csv, barn-blinds-controller.kicad_pcb, motor_drivers.kicad_sch, motor_outputs.kicad_sch, switch_inputs.kicad_sch, usb-c-5v.kicad_sch]
2026-08-07 Stock-driven part swaps (C10, U12-U16) + J3 DNP after BOM audit
    C10 (isolated 5V_ISO bulk cap): 100uF 25V (C2840614) was out of stock at
    JLCPCB. Swapped to 100uF 16V (C7432790, HGC1210R5107M160NSVK) - same 1210
    footprint, no PCB rework. 16V chosen over 10V/6.3V alternatives to keep
    DC-bias derating low on the ~5V rail (unregulated B1205S-3WR2L output).
    U12-U16 (PRTR5V0U2X ESD protection): C12333 was out of stock. Swapped to
    C5158049 (UMW/Youtai) - same SOT-143 footprint, no PCB rework. Checked
    four other "PRTR5V0U2X"-labeled LCSC listings before picking this one -
    they were mismatched (unidirectional, or 14-25V standoff instead of ~5V)
    despite sharing the part name; C5158049 actually matche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
    [VSP-WSC-4_1.3_bom-JLCPCB Assembly Order.xls, barn-blinds-controller.kicad_pcb, esp32-s3.kicad_sch, power_input.kicad_sch, switch_inputs.kicad_sch, usb-c-5v.kicad_sch]
2026-08-07 Updated footprints
    [barn-blinds-controller.kicad_pcb]
2026-08-07 JLCPCB order review: fix BOM duplicates, ESP32 variant analysis, attic notes
    BOM (production/bom.xlsx + bom.csv, corrected):
    - The Fabrication Toolkit export had 16 duplicate designator entries: the 0.1uF
    line listed 29 designators for 15 real parts, and the RESET line 4 for 2.
    Source files are clean - every refdes is unique in both schematic and PCB -
    so this was purely an export artifact. Left as-is it would inflate part
    quantities or trip a DFM hold.
    - Corrected the stale Comment on C10 (read "100uF25V"; schematic and PCB both
    say "100uF 16V"). LCSC C7432790 was already the right 16V part, so this was
    description-only - JLCPCB places by part number.
    - Corrected file verified: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
    [bom-ORIGINAL-with-dupes.xls, bom.csv, bom.xls, bom.xlsx]
2026-08-07 ESP32 variant resolved: C2913197 = N4 (correct); docs had listed the N16R8
    Confirmed from the JLCPCB inventory listing:
    C2913197 = ESP32-S3-WROOM-1-N4 4MB Quad, no PSRAM, -40~85C <- in the design
    C2913202 = ESP32-S3-WROOM-1-N16R8 16MB + 8MB Octal PSRAM, -40~65C
    The board was right all along; CLAUDE.md's key-parts table was wrong. Recording
    this as a near-miss because "fixing" the schematic to match the docs would have
    broken the board twice over: the N16R8's Octal PSRAM consumes IO35/IO36/IO37
    (datasheet Table 3 footnote b), which this design drives as ISO_STBY,
    ISO_SH1_OPEN and ISO_SH1_CLOSED on module pins 28/29/30 - losing Shade 1 and
    motor-driver standby - and the part is rated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
2026-08-07 C33/C34 electrolytics checked: C7471896 is already 105C, no change needed
    Spec confirmed: 1000uF 25V, -55~+105C, 2000h @ 105C, 60mOhm ESR @100kHz,
    1.19A ripple, D10xL10.5mm SMD.
    The failure mode worth worrying about was an 85C part; this isn't one. Ran the
    endurance numbers duty-cycle-weighted for an attic rather than at a sustained
    worst case (300h/yr @ 80C, 800 @ 60C, 3000 @ 40C, 4660 @ 20C): ~6.7% of life
    per year, so roughly a 15 year service life. A same-can 5000h part would give
    ~37 years, which is past the useful life of everything else in the enclosure.
    Ripple rating is also a non-issue here: unlike an SMPS output cap these only
    carry current during the brief motor runs, so ripple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
2026-08-07 Verify re-run fabrication outputs; drop H1-H4 from CPL; correct BOM-dupe guidance
    Checked the 2026-08-07 12:40 Fabrication Toolkit run end to end.
    Gerbers (VSP-WSC-4_1.3.zip) - clean, no changes needed:
    - All 11 layers present (F/In1/In2/B copper, both masks, both silks, both
    pastes, Edge_Cuts) plus PTH and NPTH drill files and drill maps.
    - Edge_Cuts outline parses to 65.004 x 73.935 mm, matching the board exactly.
    - PTH minimum drill 0.300 mm, matching the ordered "min via hole 0.3mm" spec.
    - CPL shares the gerber coordinate frame (absolute KiCad coords, Y negated), so
    the two align.
    BOM (VSP-WSC-4_1.3_bom.csv) - clean, no changes needed:
    - 40 lines, 106 placements, zero duplicate de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
    [VSP-WSC-4_1.3_bom.csv, VSP-WSC-4_1.3_positions.csv, barn-blinds-controller.kicad_pcb, barn-blinds-controller.kicad_sch]
2026-08-07 Solve the JLCPCB BOM duplicate-designator root cause; add pre-merged upload BOM
    The duplicates are reproducible and now explained. JLCPCB's parts-matching flow
    duplicates designators when a single LCSC part number appears on more than one
    BOM line - it merges the lines but concatenates the designator lists wrongly.
    Exactly two part numbers were affected, accounting for all 16 duplicates:
    C1590 toolkit emits "0.1uF" (x11) and "0.1uF 25V" (x4) -> 15 dupes
    C51927445 toolkit emits "RESET" (SW1) and "BOOT" (SW2) -> 2 dupes
    Verified: the set of duplicated designators is exactly the set of designators
    sitting on a multi-line LCSC.
    Fix is to pre-merge so JLCPCB has nothing to mer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
    [VSP-WSC-4_1.3_bom-UPLOAD.csv, bom.xls]
2026-08-07 Rev 1.3 ordered: close out order review, record two accepted vendor decisions
    Order placed 2026-08-07, gerber VSP-WSC-4_1.3_Y18: 5 boards, PCBA both sides,
    4-layer 1oz/0.5oz, S1000H TG155 (JLC-4), ENIG 1U", plugged vias, Confirm Parts
    Placement and Photo Confirmation both on. Nothing outstanding; next action is
    bring-up when the boards arrive.
    Recording two items as SETTLED DECISIONS rather than open issues, both closed by
    the user from direct experience with this vendor. Docs now say explicitly not to
    re-flag them, because both look like defects on a fresh read of the files:
    - Assembly remark left empty. U1's DCDC_HYBRID_SLC03_TEC2 footprint overlays
    three DC-DC hole patterns and the BO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
2026-08-27 Repo cleanup ahead of Rev 1.3 bring-up
    Commit the untracked files that belong with existing tracked siblings, and
    clear out scratch:
    - Assembly.3mf, project-case.amf: enclosure exports from the same FreeCAD
    sessions as the already-tracked project-case.3mf / project-case-Cut001.amf
    and the rev2 STLs.
    - C2913197.pdf: ESP32-S3-WROOM-1-N4 datasheet, matching the other root-level
    C*.pdf LCSC datasheets. Note LCSC serves one shared family datasheet for the
    whole ESP32-S3-WROOM-1 line -- the C2913202.pdf downloaded during the variant
    investigation was byte-identical to this one, so the datasheet cannot be used
    to tell N4 from N16R8. Dropped as a duplicate.
    - report.txt: stale placement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
    [Assembly.3mf, project-case.amf]
2026-08-27 Docs: boards received, switch status to bring-up
    Rev 1.3 boards arrived from JLCPCB 2026-08-27.
    CLAUDE.md:
    - Status and PICK UP HERE rewritten from "waiting on boards" to bring-up,
    with the four things that bite first ordered by likelihood: ACS725 divisor
    (0.264, not 0.4), internal pull-ups on all 8 switch GPIOs, D4/D5 being
    hardware-default-ON, and Tasmota Shutters 3&4 being what this build exists
    to validate.
    - Added the as-built quirks of this specific run in one place: J3 DNP'd so
    native USB is the only flash path, U1 on the Heniper 'H' holes, C10 and
    U12-U16 stock substitutions.
    - Recorded the git markers: release/v1.3 and the v1.3-fab tag at 3bc6a34.
    - Fixed a dangling poi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
2026-08-27 Add Rev 1.3 ESPHome bring-up config and procedure
    The existing vsp-wsc4-standalone.yaml is a Rev 1.2 pinout -- every motor
    GPIO moved in the Rev 1.3 reshuffle, so it must not be flashed to these
    boards. This adds a purpose-built bench config instead of editing it.
    vsp-wsc4-rev13-bringup.yaml -- validates clean under `esphome config`
    (ESPHome 2026.8.1). Written against the Rev 1.3 GPIO map:
    - flash_size: 4MB. The esp32-s3-devkitc-1 board definition assumes 8MB,
    which the N4 cannot hold. No psram block, since the N4 has none.
    - logger hardware_uart: USB_SERIAL_JTAG, required for a console over the
    native USB port. J3 is DNP'd, so there is no UART fallback on this run.
    - Motor STBY default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
2026-08-27 Bring-up config AP-only; document the blank-board USB boot loop
    First Rev 1.3 board powered up 2026-08-27. The USB port appeared to
    connect/disconnect endlessly. Diagnosed: the chip is blank, not broken.
    Flash ships erased, the ESP32-S3 ROM finds no valid image, the RTC watchdog
    resets, and each reset tears down the USB-Serial-JTAG peripheral. Metronomic
    2.673 s period with zero USB errors in dmesg -- a real USB fault gives -71 /
    -110 and failed descriptor reads. esptool synced and ran a stub flasher over
    native USB, clearing the whole USB path including U16 and its via stub, and
    flash at 0x0 read back all 0xFF. The same symptom on an unrelated board was
    the same cause: both were unprogramm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
    [vsp-wsc4-rev13-bringup.yaml]
2026-08-28 Fix motor channel cross: ISO_SHn_* nets drive the wrong SHADEn terminal
    First motor bring-up on the Rev 1.3 board: a motor correctly wired to SHADE4
    (J4 pins 10/20) would not move on any "Shade 4" command. Traced to the
    netlist -- on BOTH TB6612FNGs the A/B channel control signals are crossed
    with the output terminals, swapped within each pair:
    U9 ch A <- SH2_* control -> AO1/AO2 = SHADE1 (J4 7/17)
    U9 ch B <- SH1_* control -> BO1/BO2 = SHADE2 (J4 8/18)
    U8 ch A <- SH4_* control -> AO1/AO2 = SHADE3 (J4 9/19)
    U8 ch B <- SH3_* control -> BO1/BO2 = SHADE4 (J4 10/20)
    The bring-up config trusted the net names, so commanding "Shade 4" energized
    the SHADE3 terminals -- an empty channel. No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
    [vsp-wsc4-rev13-bringup.yaml]
2026-08-31 Add live bring-up status log for on-site handover
    Picking this up on site from a different machine, so everything needed is
    now git-tracked rather than living in one session.
    New docs/project-context/vsp-wsc4-rev13-bringup-status.md -- the "where did
    I leave off" file:
    - Verified-on-hardware vs still-open, kept honest. Notably NO motor has yet
    been seen to turn: the channel-cross bug was found and fixed in the config
    on 2026-08-28, but that fix is still unconfirmed on hardware. That
    confirmation is the single next action.
    - Also still open: SW2-SW4, TMP235 sanity check, ACS725 (0.264 divisor
    unproven against a clamp meter), +12V / +3.3V_MOTOR never measured, motor
    direction vs UP/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
2026-09-04 Move off-sheet elements back onto the USB/5V sheet
    Elements on usb-c-5v.kicad_sch had drifted outside the sheet boundary.
    Shifts the affected junctions and wires back into the drawing area
    (+24.13 mm x, +45.72 mm y). Geometry only -- no connectivity change.
    Authored by Tim Irvin; committed here after being accidentally reverted
    and restored from IDE local history.
    Claude-Session: https://claude.ai/code/session_0152N7pZMoHZxkvV4x7TCixF
    [usb-c-5v.kicad_sch]
2026-09-04 Confirm channel mapping on hardware; open the Rev 1.4 change list
    Bring-up session 2026-09-03 on the Rev 1.3 boards.
    Channel mapping CONFIRMED ON HARDWARE. Shade 1->1, 2->2 and 4->4 all drive
    the correct J4 terminal with the config's swap applied, so the table is
    right and must not be "fixed" back toward the net names. Root cause found:
    when the pin order was reworked for the new J4 terminal block the labels on
    the TB6612FNG output side were re-pointed but the input side was not. The
    isolators (ISO7760DBQ) pair 1:1 and add no cross of their own.
    Board 1 is out of service. An unsuitable test motor (280 frame, 0.9 A
    no-load against a 1.1 A polyfuse, ~6-8 A inrush against a 3.2 A peak
    rating)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
    [vsp-wsc4-rev13-bringup.yaml]
2026-09-04 All 4 channels verified on hardware; trim the Rev 1.4 list
    All four output channels now drive both directions and produce ±12 V at
    their terminals (DMM, board 2). SHADE3 included -- it had never been driven
    on any board before. The channel mapping question is fully closed; next
    open item is the ACS725 /0.264 divisor against a known resistive load.
    Rev 1.4 list trimmed from eight items to six after review:
    - Test points: keep, and extend. Every test point should carry its NET NAME
    on silkscreen, not just TP1/TP4 -- today you have to open the schematic to
    learn what a test point connects to, which is the wrong moment for it.
    - J3: CLOSED, stays DNP. The plated holes are sufficient -- so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
2026-09-04 Correct the via-in-pad record; drop it from the Rev 1.4 list
    Via-in-pad was resolved long ago by moving vias to pad edges. The claim in
    CLAUDE.md that "96 of 177 vias still sit inside SMD pads" counted via
    CENTRES, which conflates "centred in the pad" with "shoved to the rim", and
    overstated the issue.
    Measured 2026-09-03 against the current PCB. Of 177 vias, 104 have their
    centre over an SMD pad, but:
    48 straddle the pad edge -- via body hanging outside the pad
    33 sit on large pads (>=1 mm^2), where it is moot
    23 are on 0402 pads (0.9 x 0.95 mm) with 0.10-0.20 mm clearance inside
    the edge -- on a 0.45 mm half-width with a 0.6 mm via, that is as far
    out as the geometry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
2026-09-04 Reframe Rev 1.4 protection around surviving an unknown load
    Design target set by the user 2026-09-03: the outputs must be robust against
    whatever gets connected, not merely matched to the known-good shade motors.
    Those motors were characterised early in the project and are not the design
    case -- what destroyed board 1's U8 was a non-shade motor on the bench, and
    if this becomes a more general-purpose product there is no knowing what a
    user will connect.
    Rewrites Rev 1.4 items 2 and 3 accordingly. Item 2 is now the governing
    requirement, with a table of what the current design gets wrong: the
    TB6612FNG's 15 V absolute-max VM on a 12 V rail with only thermal shutdown
    for self-protection, D6-D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
2026-09-04 Record the shade-motor stall figure; cut the unvetted Tg analysis
    Shade motors draw well under 1 A each even at a full stall induced by
    hand-holding the shade -- much lower than expected. Recorded from memory
    2026-09-03; the original measurements were never written down and the motors
    are now on the job site, so it is "well under 1 A", not a precise value.
    This makes the 1.4 A stall threshold worse than mis-ordered -- it is above
    anything these motors can produce, so a genuine stall would never fire it.
    F1-F4 at 1.1 A hold are likewise above the motors' stall current and offer
    no protection for the intended load. Neither is a fault; both confirm that
    the design case is an unknown load, not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
2026-09-04 Correct the protection roles: the fuse was never the stall protection
    Design decision from early in the project, which the previous two commits
    were quietly overriding: F1-F4 exist for catastrophic faults -- a short, or a
    load the board was never meant to drive. Stall protection is the current
    reading, and that is why the ACS723/ACS725 is in the circuit at all. F1-F4
    sitting above the motors' stall current is therefore correct by design, not a
    gap, and the fuse rating should not be changed to chase stalls. Recorded in
    handover.md and CLAUDE.md as settled so it stops being re-raised.
    Rev 1.4 item 3 reframed accordingly: it is no longer about "protection
    ordering" but about the fact that the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
2026-10-12 Rev 1.3 motor-less bring-up complete; Tasmota verified on all 4 shutters
    Bench results on board 2 with resistive loads (2026-10-11):
    - ACS725 /0.264 proven: 5-point fit 0.271 V/A, linear within 2 mV,
    firmware reads within +2.5 % up to 1.83 A; noise about 0.04 A
    - All 4 channels at once (1.93 A) with no reboot; drivers near 104 F
    - Rails measured idle and loaded; U1 is unregulated, so the ESP32
    browns out below about 8.5 V on +12V_RAW (quantifies Rev 1.4 item 4)
    - All 8 switch inputs pass; firmware debounce needed in every config
    - U7 (AMS1117) is the board hot spot; added as Rev 1.4 nice-to-have
    - Tasmota drives all 4 shutters correctly via a template. Its Module
    page hides GPIO33-37 (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
2026-10-12 Add Rev 1.3 barn configs; record both barn units and the J3 brownout
    - barn-overhead.yaml (Front, Middle, Back, Workshop) and
    barn-windows.yaml (Bar, Back, Front, Workshop): production ESPHome
    for Rev 1.3, ported from the Rev 1.2 barn-shades-pcb.yaml. Includes
    the channel swap, driven PWM pins, soft-start ramp, ACS725 /0.264
    with stall stop, debounced wall switches and a local web page.
    The two files differ only in the substitutions block.
    - Board 2 flashed as barn-overhead, board 3 (N4 confirmed) as
    barn-windows, both over J3; web pages verified on the bench.
    - Status log: barn motor test plan, updated board inventory, and
    Finding 16. Running from the USB-TTL adapter's 3.3 V w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
2026-10-12 Reorganize repo into pcb/ enclosure/ firmware/ docs/ purchasing/
    Match the vesprio-thermostat layout. Pure moves plus path fixups:
    - KiCad project -> pcb/main-board/, project libraries under lib/
    (symbols, footprints, the five project 3D models, silkscreen artwork).
    Library tables and every ${KIPRJMOD} model path repointed; all resolve.
    - production/ fab sets -> pcb/main-board/fab/vsp-wsc4-rev1.{2,3}/
    - Enclosure rev 1 / rev 2 / reference models -> enclosure/
    - ESPHome configs -> firmware/esphome/ (Rev 1.2 config -> legacy/),
    Tasmota commands -> firmware/tasmota/
    - Bring-up docs -> docs/bringup/, todo -> docs/todo.md,
    handover -> docs/handover-rev1.2.md, datasheets -> docs/datasheet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
2026-10-12 Delete stale outputs and unused vendor libraries
    Git history and the vX.Y-fab tags keep all of it.
    - gerbers/, gerbers-v1.1/, v1.1 BOM/CPL spreadsheets, superseded
    production/bom.*, JLCPCB sample templates, old BOM csv, version.bin
    - Vendor library downloads the design does not reference: 1054070,
    1786918 (all-CAD bundle; footprint/symbol/model already in the project
    lib), 1787470, 1790373, KH-TYPE-C-16P (USB-C, dropped in Rev 1.3),
    LIB_SLC03A-05, EEVTG2A221M, the JL271R 8-pin terminal block (Rev 1.0),
    R15P23.3S, the EasyEDA ProLib export, slc03a-05.kicad_sym
    - Six project footprints no longer placed on the board
    - Duplicate datasheet C20306292.pdf
    Replaced the July board STEP (p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
2026-10-12 Start ADRs; back-fill 19 decisions and add a living architecture doc
    docs/decisions/ follows the hourarc convention (adr-NNN-slug.md, README
    index, accepted ADRs immutable). ADR-002..019 are back-filled from
    CLAUDE.md, the todo list and the bring-up log, dated when each decision
    was made: N4 module, dual firmware track, functional isolation, stall
    protection via current sense, ADC1, switch-input protection, USB
    diode-OR, Micro-USB, J3 DNP, the 1786918 block, the channel cross,
    Tasmota by template, U1 shared footprint, fab spec, release/-fab
    convention, Rev 1.3 as-is, Rev 1.4 unknown-load requirement, enclosure
    Rev 3. ADR-020 records today's layout and branch roles.
    docs/architecture.md hold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
2026-10-12 Slim CLAUDE.md to a repo map and rules; add READMEs; fix moved paths
    CLAUDE.md drops the decision history (now ADRs) and the current-state
    detail (now docs/architecture.md), keeping the layout, status, branch
    roles, non-negotiable rules and the KiCad workflow. Adds README.md at
    the root and in pcb/main-board, enclosure and firmware. References to
    moved files and to old CLAUDE.md sections now point at the new paths
    and ADRs; the Rev 1.2 handover is marked historical. YAML changes are
    comments only.
2026-10-12 Ship the ESP32-S3-WROOM-1 3D model in the project library
    U3's model path used ${KICAD8_3RD_PARTY}, which KiCad 10 does not
    define, so STEP exports silently dropped the module. It now resolves
    from ${KIPRJMOD}/lib/3dmodels like the other project models. Model
    path only; DRC unchanged (0/0).
2026-10-13 Enclosure Rev 3: spreadsheet-driven FreeCAD model for the Rev 1.3 board
    enclosure/rev3/build_case_rev3.py generates project-case-rev3.FCStd
    (FreeCAD 1.1, headless): Bottom tray + Lid PartDesign bodies whose every
    dimension is an expression on a Params spreadsheet. Defaults are Rev 2's
    own sketch values (wall, standoffs, tongue/groove, M3 counterbores,
    2.8 mm post holes, keyholes, vents) with placements re-derived from the
    as-fabbed Rev 1.3 PCB and board STEP.
    check_case_rev3.py is the fit gate: feature health, interference and
    clearance against every board part, a parameter-robustness pass, and
    STL + PNG export. Current result: PASS, no interference; tightest
    clearances jack 0.11, USB 0.23,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
2026-10-13 Enclosure Rev 3: chamfer the tongue's top edges like Rev 2
    Rev 2's alignment ridge had a 0.25 mm chamfer on its top edges, part of
    the 'ridge too tight' fix from test print 1. Rev 3 now has it too, as a
    ridge_chamfer parameter. It is built from tapered pad/pocket features, not
    an edge-referencing Chamfer, so it survives spreadsheet edits. Verified
    by section: both edges step in 0.24 mm over the top 0.25 mm. Fit check
    still PASS, robustness pass all ok.
2026-10-13 Enclosure Rev 3: two DIN clips on the back, plus a -X side mount
    The clips bought are the generic Phoenix USA 10 copy (42.6 x 10, three
    holes 25 mm across the outer two); the existing 12.5 mm pitch fits them.
    - Back: two clips at y -8 and +31 (din_cy / din_spacing), either side of
    the keyholes. Not near -Y, where a boss would hit U1's pins.
    - Side: one clip on the -X wall of the lid (side_cy / side_cz), holes
    along Y with bosses inside, terminal block facing out. Side mounting on
    a Y wall was rejected: it covers vents, and the +Y wall has the bulk
    caps behind it.
    Fit check PASS, no interference; the second back clip's boss clears the
    nearest underside caps by 0.31 mm. Robustness pa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
2026-10-13 Enclosure Rev 3 README: fit-test print settings and checklist
2026-10-13 Enclosure Rev 3: close the keyholes from inside, as Rev 2 did
    The keyhole entry and slot went straight through the tray, leaving the wall
    screw or nail head open to the board underside. Add a 0.6 mm cap (kh_cap_t)
    over each head channel; the head now slides in a closed 1.3 mm channel.
    The checker probes both keyholes and fails if either is open from inside,
    including in the parameter-robustness trials.
2026-10-13 Enclosure Rev 3: deepen the keyhole head channel to 1.8 mm
    kh_recess 0.5 -> 1.0 so an ordinary low pan head fits under the cap.
    Leaves 1.5 mm of floor as the keyhole lip. Checker: PASS, clearances
    unchanged.
2026-10-13 CLAUDE.md: point at Enclosure Rev 3
    Rev 3 is modelled and in its first test print; the directory map and status
    line still called rev2 current and Rev 3 the next job. Also cite ADR-022 in
    enclosure/README.md.
2026-10-13 Enclosure Rev 3: fix vents and tongue from fit print 1, add markings
    Fit print 1: the board fit perfectly, but the tongue barely engaged and
    most vents were missing.
    - Vents: FreeCAD 1.1 doesn't move a body's Tip to a new LinearPattern,
    so the lid ended at the first slot of each row. The builder now sets
    the Tip. The checker fails if a Tip isn't the last feature or if any
    vent slot is blocked.
    - Tongue: 0.55 x 0.5 mm -> 0.9 x 1.5 mm, centred in the wall; groove
    1.2 x 1.7 mm. Side vents raised to clear the deeper groove.
    - Top vents: two 30 mm bands over U7/U11/U8 and U1, freeing the centre.
    - Lid top, flush 0.6 mm inlays (separate STLs for multi-colour):
    - brand: Vesprio lockup an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
2026-10-15 Enclosure Rev 3: write-on panels, side tag, inlay test tile, closed meshes
    - Lid top: 40 x 14 mm white write-on panel in the labels inlay, for marking
    what the unit drives (logo up 1.5 mm, tagline down 3.5 mm to make room).
    - +X wall: 0.6 mm pocket for a separate white side tag (side-tag.stl),
    facing out on a side rail mount. Printed flat in the lid job; glued in.
    - Inlay test tile (build_test_tile.py). v1 settled mark_d = 0.6 and showed
    the small labels, icons and tagline blur: elephant foot compensation eats
    layer-1 strokes, and letter gaps are as narrow as 0.14 mm. v2 has line
    and gap ladders and bigger label / icon / tagline variants.
    - marks.py: marking geometry shared by the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
2026-10-15 Enclosure Rev 3: monoline lettering, printability gate, lid-top proof
    Tile v2 measured the printer (black PETG, 0.4 nozzle, elephant foot
    compensation 0, Arachne): 0.6 mm lines print clean and 0.5 mm gaps stay
    open. DejaVu at the 3 mm the J4 rows allow has sharp stroke ends and
    0.14-0.4 mm gaps, and blurred.
    - marks.printability(): rasterises a marking and fails strokes a 0.6 mm
    pen can't draw and gaps a 0.5 mm pen can't enter. Reproduces both tile
    v2 ladders exactly. The checker runs it on every mark, and now requires
    0.5 mm between any two marks, not just no overlap.
    - marks.mono_text(): monoline upper-case lettering, 0.64 mm round-ended
    strokes, counters and letter gaps >= 0.54 m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
2026-10-15 Enclosure Rev 3: real copyright symbol on the tray underside
    The underside line is now "(c-in-circle) 2026 VESPRIO.IO" instead of
    "(C)". The monoline (c) is 4.6 mm across, larger than the 3 mm letters:
    the smallest C-in-a-ring whose opening, counter and ring gap all hold the
    printer's 0.6 mm stroke / 0.5 mm gap limits. It passes printability() with
    nothing excused. Checker PASS; lid proof rebuilt (unchanged markings).
    Claude-Session: https://claude.ai/code/session_01RcdxigrLxDbkLQ8SDYB71H
2026-10-16 Enclosure Rev 3 README: lid proof 1 results and next steps
    Textured-plate proof: logo, panel and icons good; small white labels blur
    (closed counters fill in, BTM=DN reads as DTM=ON) and the blue tagline is
    patchy. MIN_GAP 0.5 came from a long slot and is too loose for short closed
    counters. Next: reprint the same proof on smooth PEI with glue stick (week
    of 2026-10-19), then decide on the legend redesign options listed.
    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
